FredericSegard/Original-Z80-Homebrew/2 - Clock/Docs and images/2 - Clock without components.jpg

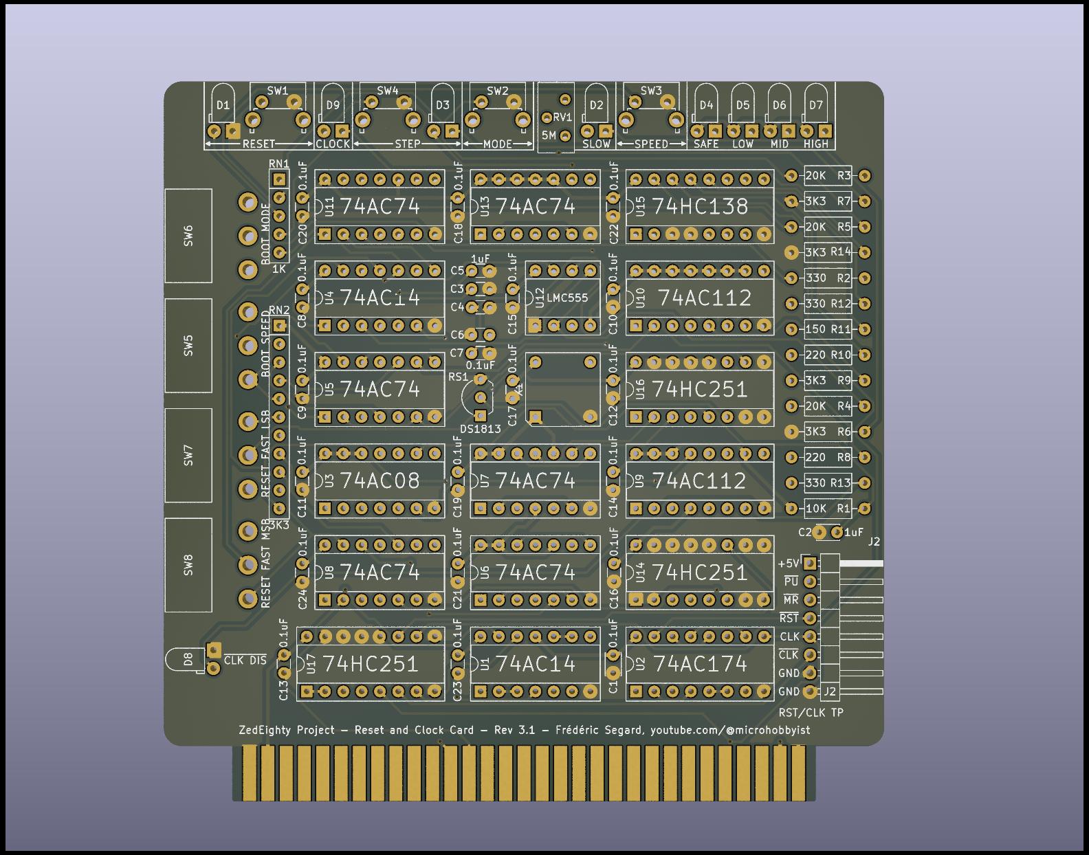
2 - Clock/Docs and images/2 - Clock without components.jpg
