FredericSegard/Original-Z80-Homebrew/README.md

# Original Z80 Homebrew
 This is my original homebrew design
