FredericSegard/Original-Z80-Homebrew/2 - Clock/Docs and images/2 - Clock back.jpg

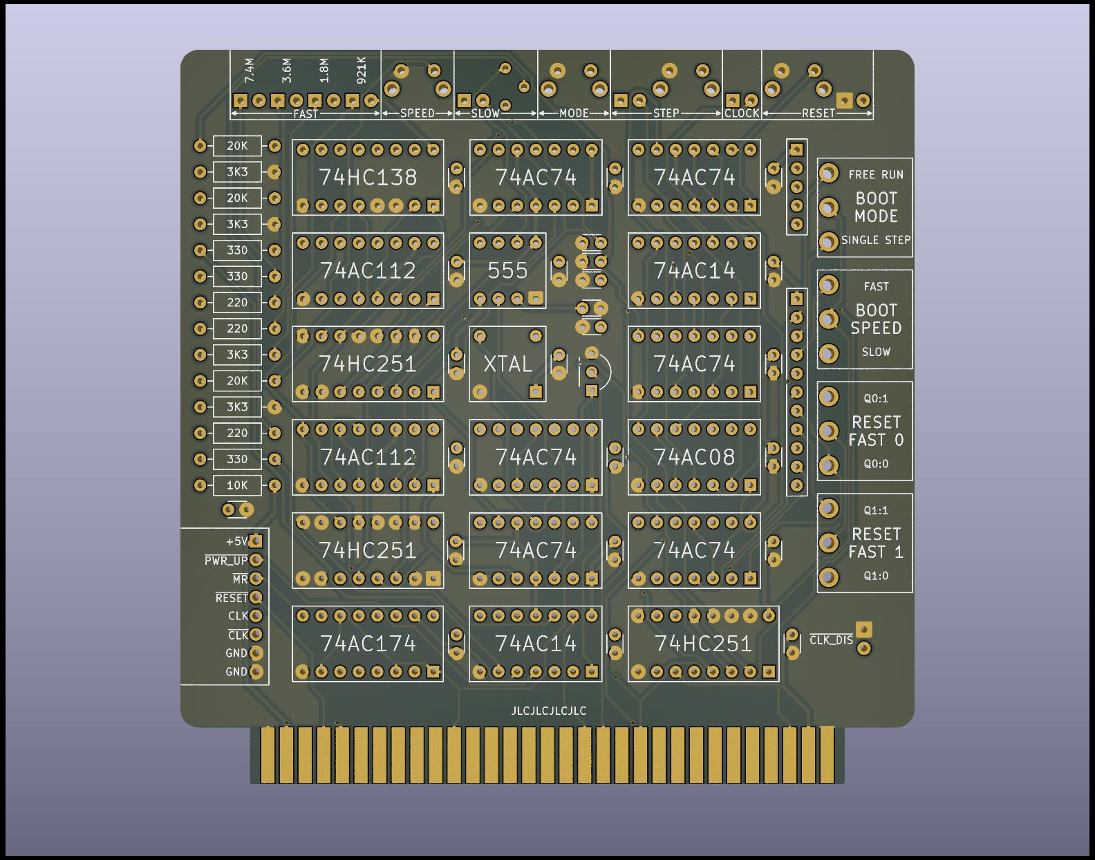
2 - Clock/Docs and images/2 - Clock back.jpg
