FredericSegard/Original-Z80-Homebrew/4 - Quad serial/Docs and images/4 - Quad serial (view 1).jpg

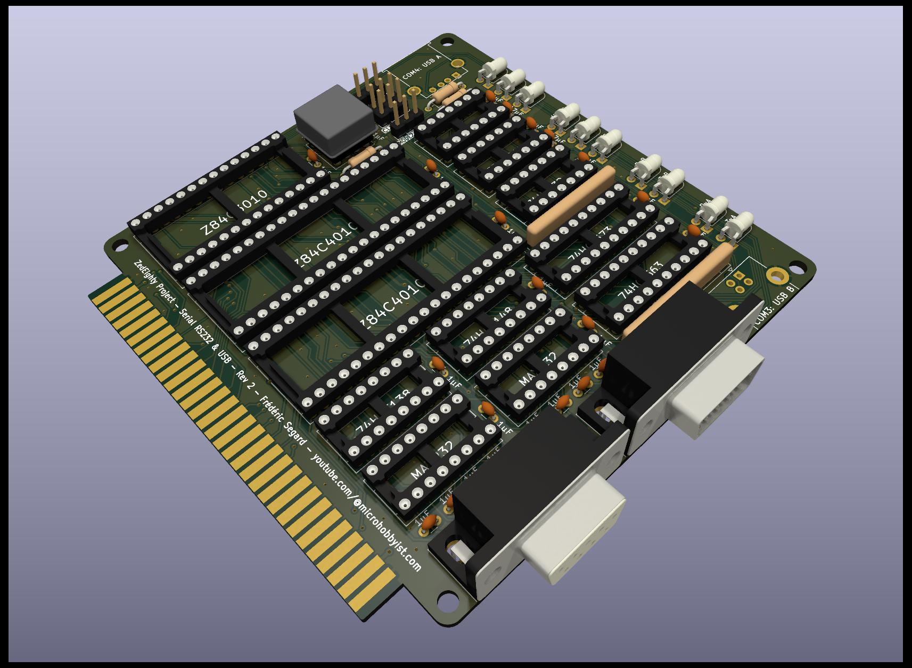
4 - Quad serial/Docs and images/4 - Quad serial (view 1).jpg
