FredericSegard/Original-Z80-Homebrew/1 - Backplkane/Docs and images/1 - Backplkane - front with components.jpg

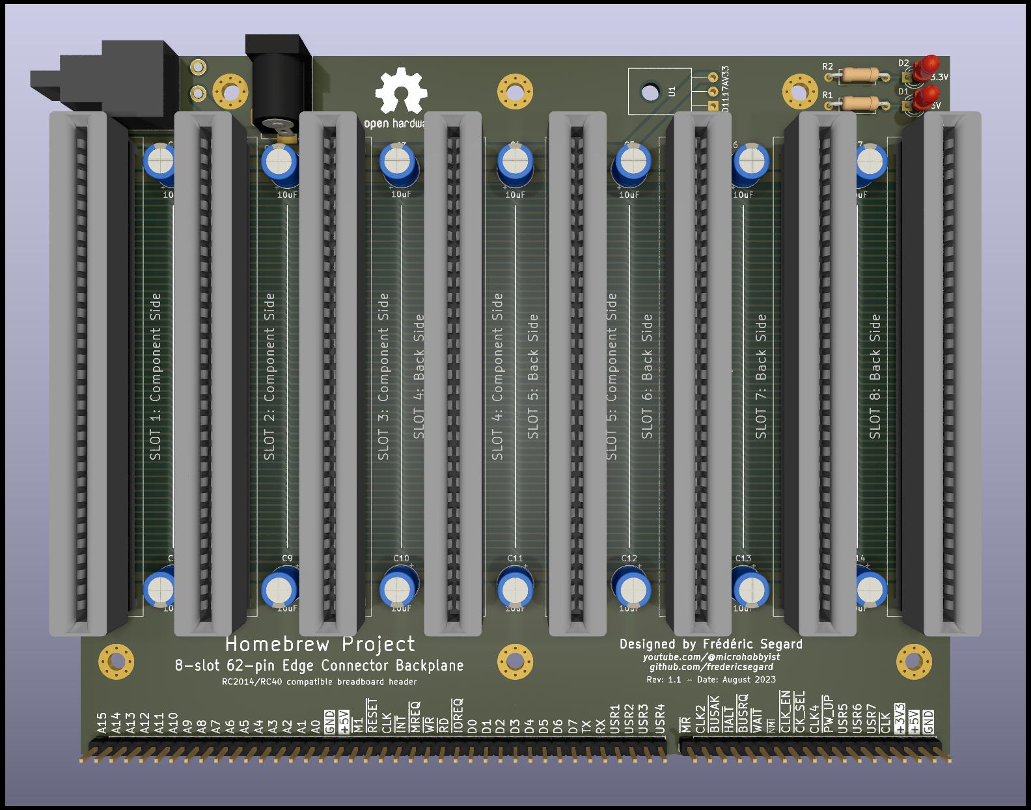
1 - Backplkane/Docs and images/1 - Backplkane - front with components.jpg
