FredericSegard/Original-Z80-Homebrew/1 - Backplkane/Docs and images/1 - Backplkane - front without components.jpg

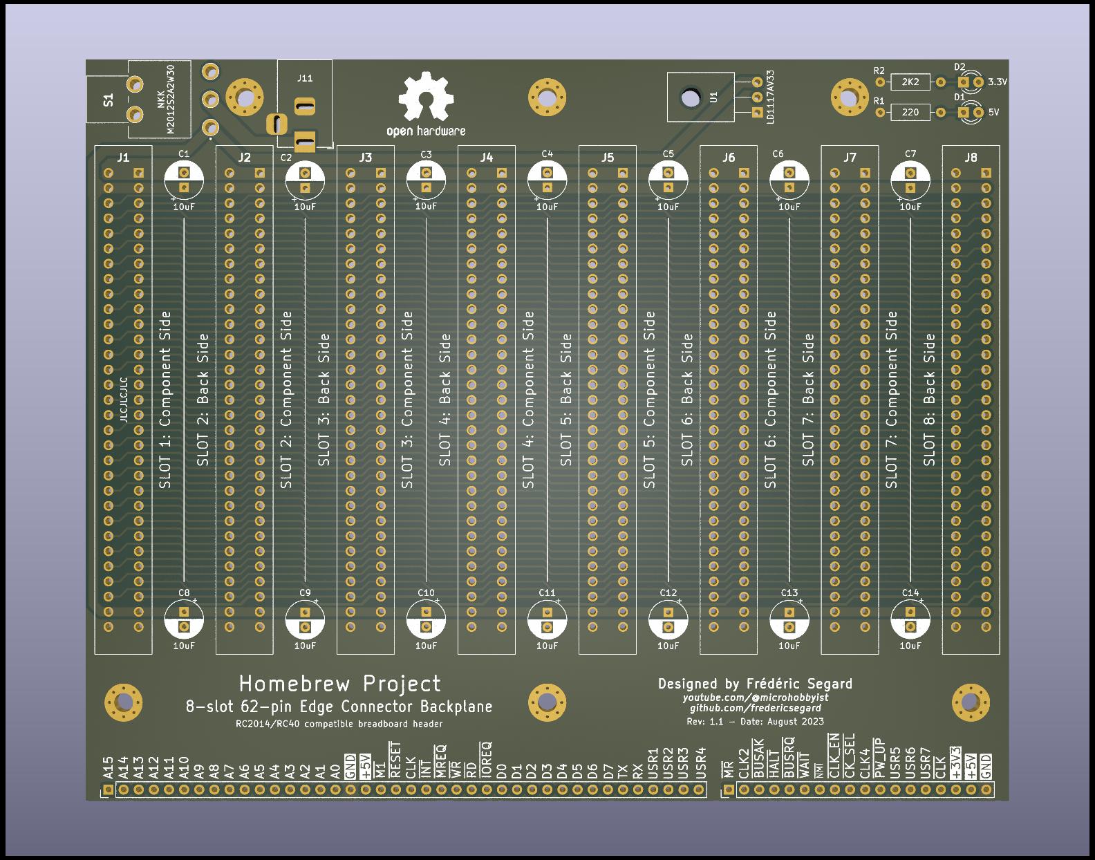
1 - Backplkane/Docs and images/1 - Backplkane - front without components.jpg
