FredericSegard/Original-Z80-Homebrew/3 - CPU and memory/Docs and images/3 - CPU and memory with components.jpg

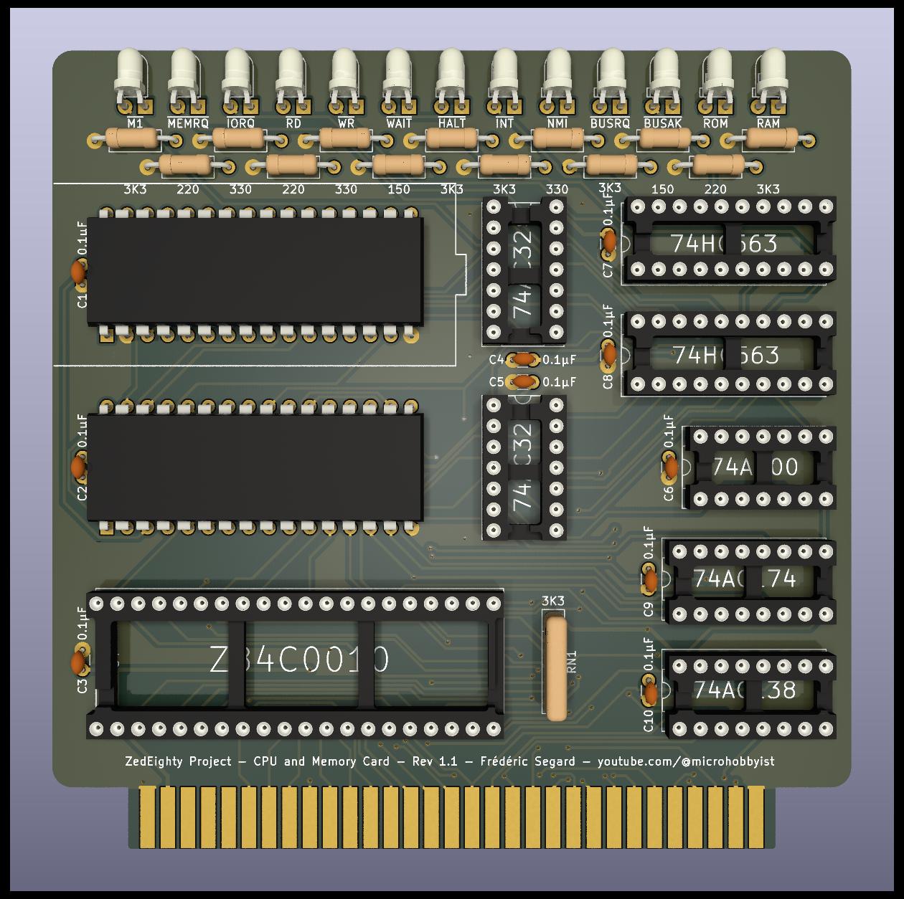
3 - CPU and memory/Docs and images/3 - CPU and memory with components.jpg
