FredericSegard/Original-Z80-Homebrew/4 - Quad serial/Docs and images/4 - Quad serial.jpg (front with components).jpg

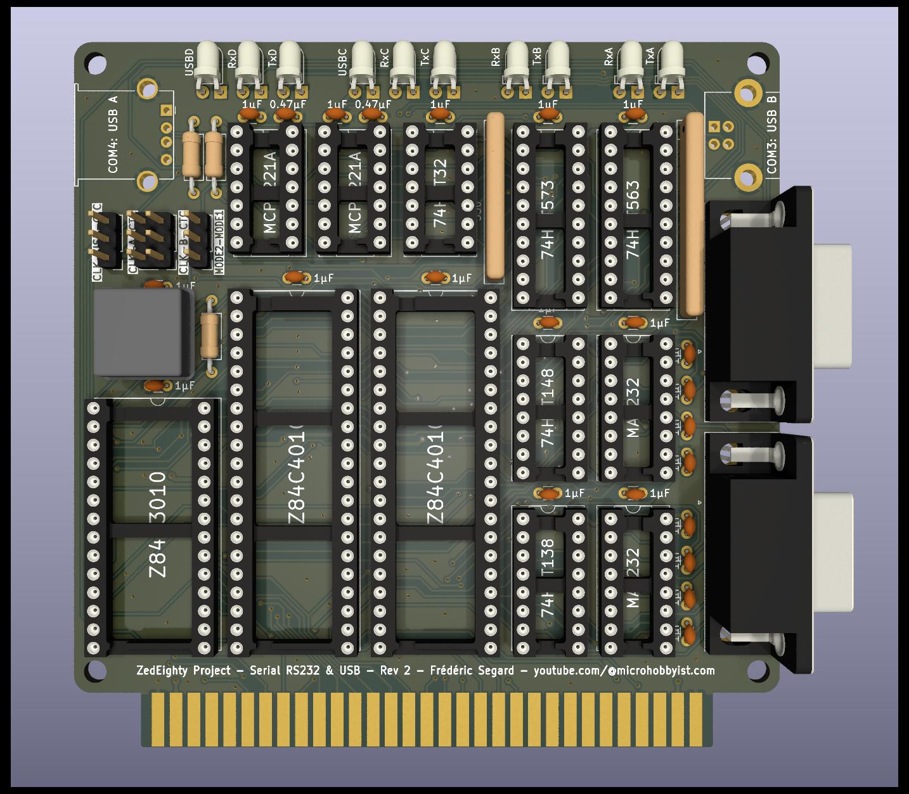
4 - Quad serial/Docs and images/4 - Quad serial.jpg (front with components).jpg
