FredericSegard/Original-Z80-Homebrew/4 - Quad serial/Docs and images/4 - Quad serial.pdf

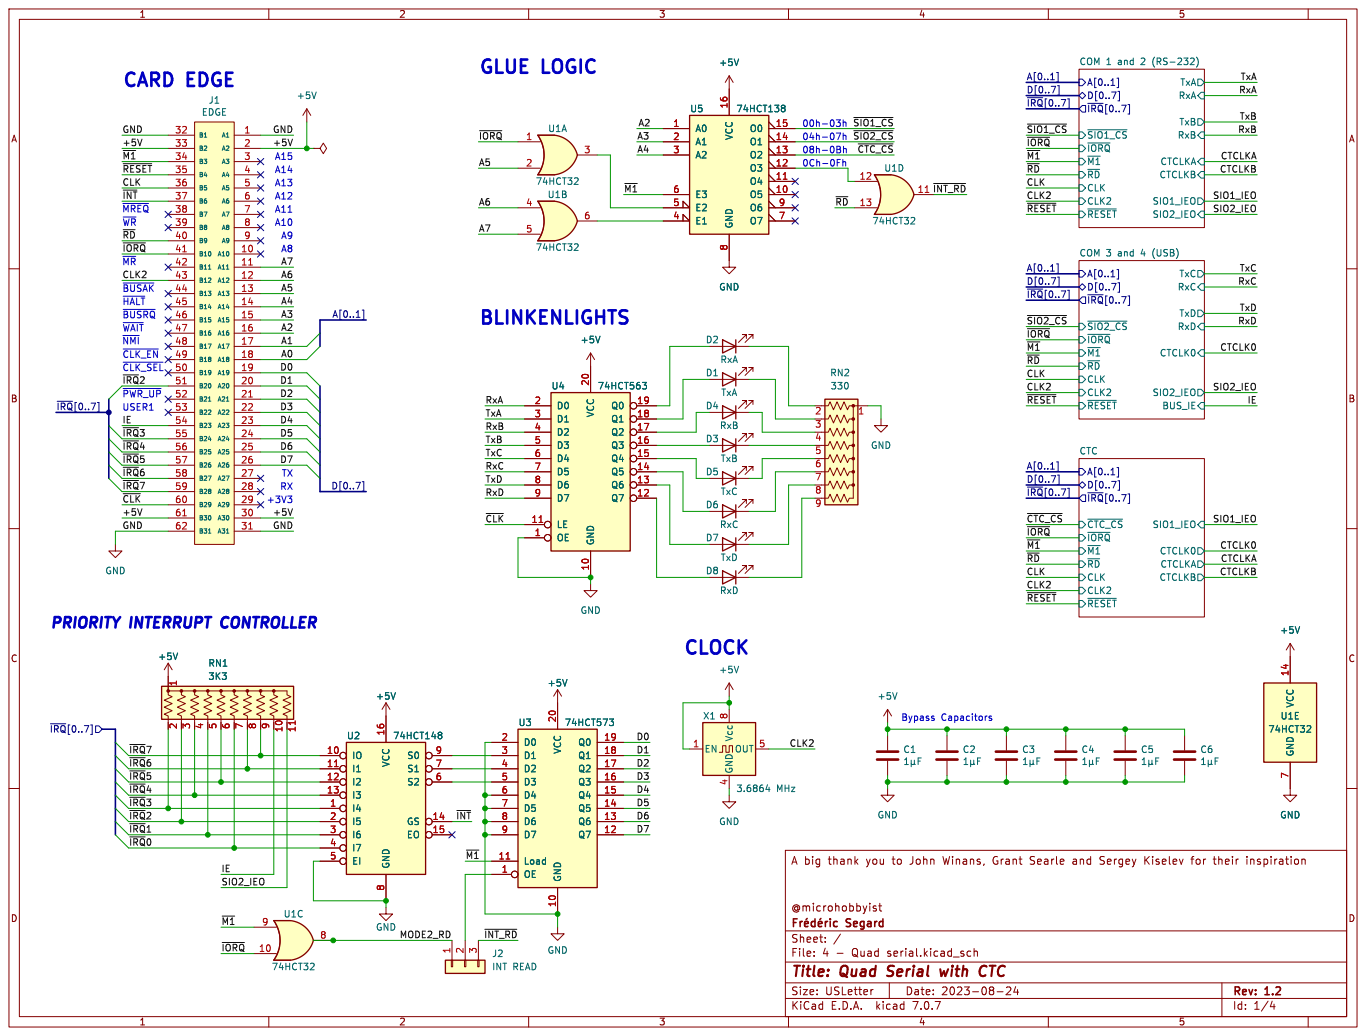
[picture p13: page 1]

CTCLKA CTCLKB COM 1 and 2 (RS-232) TxD

CTCLKA CTCLKB CTC GND

Id: 1/4 Title: Quad Serial with CTC

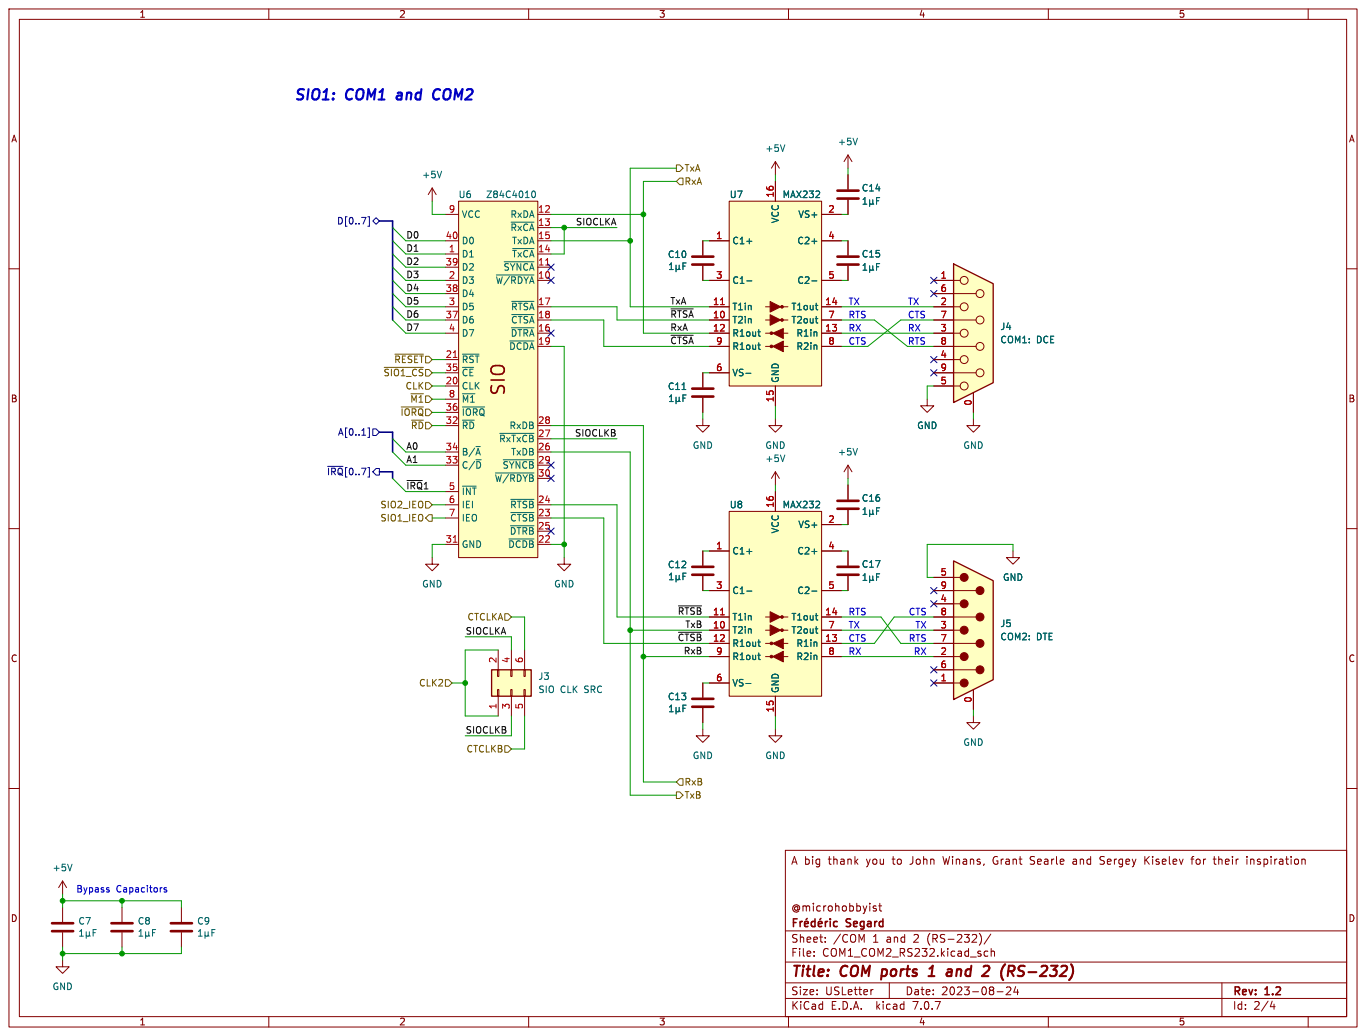
[picture p14: page 2]

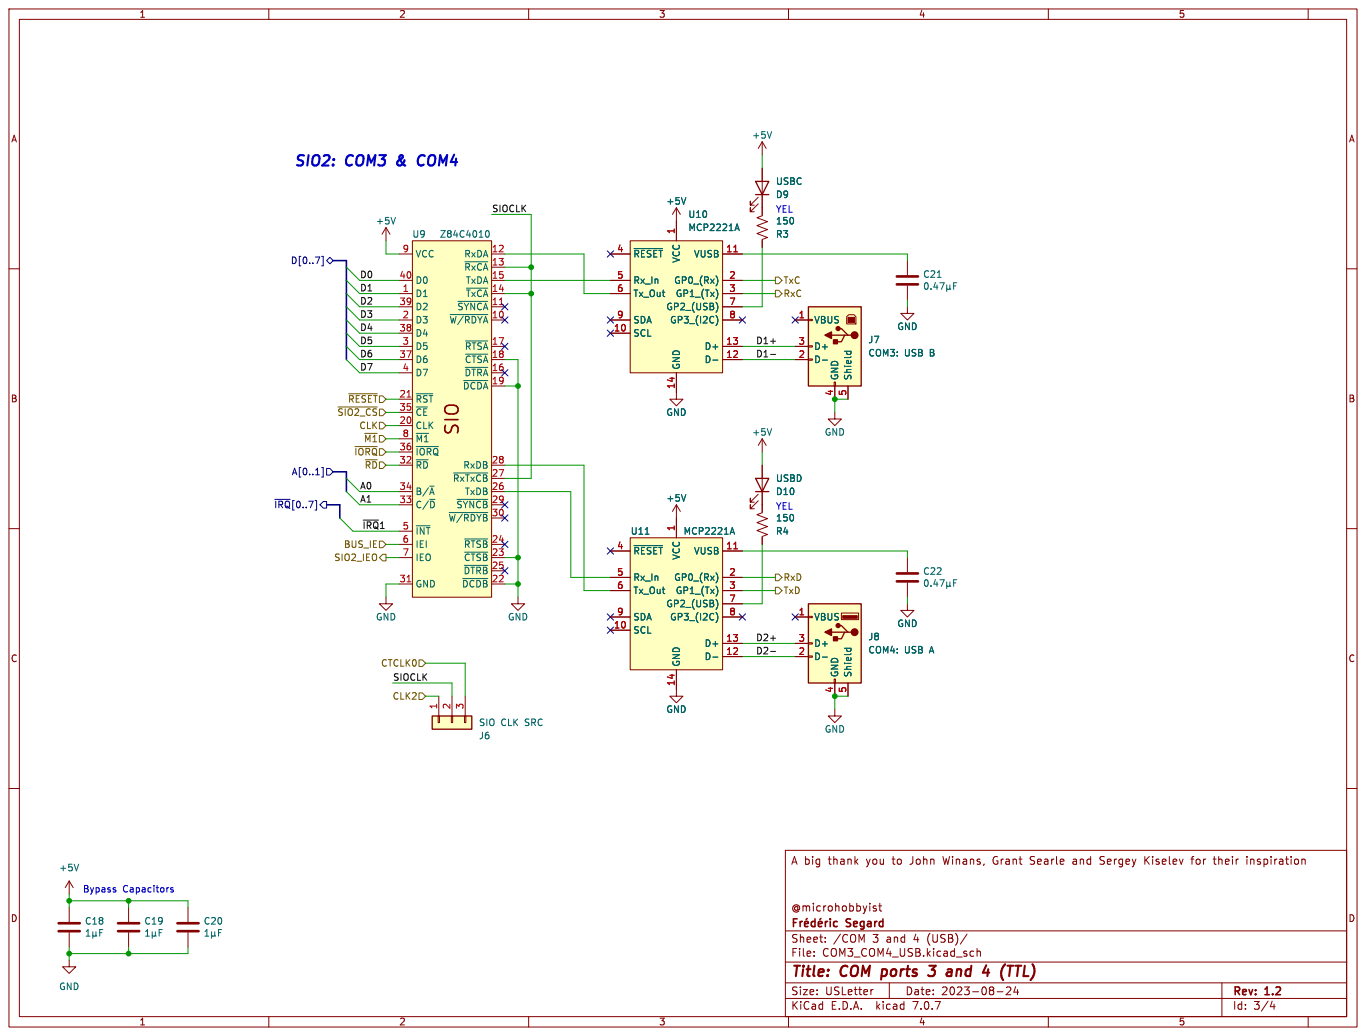
[picture p15: page 3]

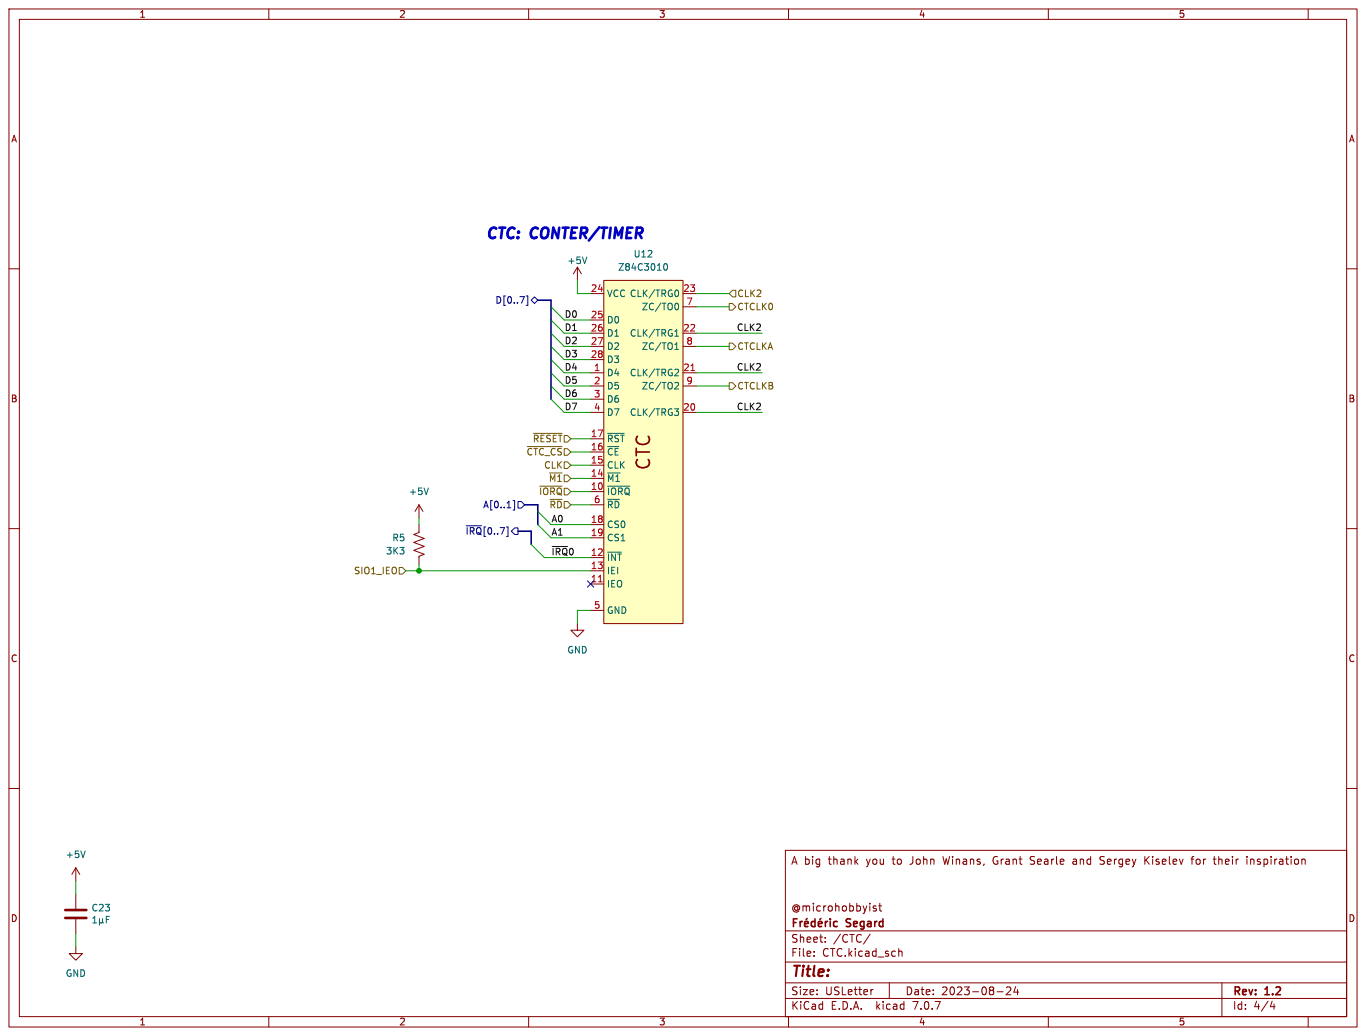
[picture p16: page 4]

Id: 4/4 Title: File: CTC.kicad_sch Sheet: /CTC/ þÿFrédéric Segard
