FredericSegard/Original-Z80-Homebrew/3 - CPU and memory/Docs and images/3 - CPU and memory.pdf

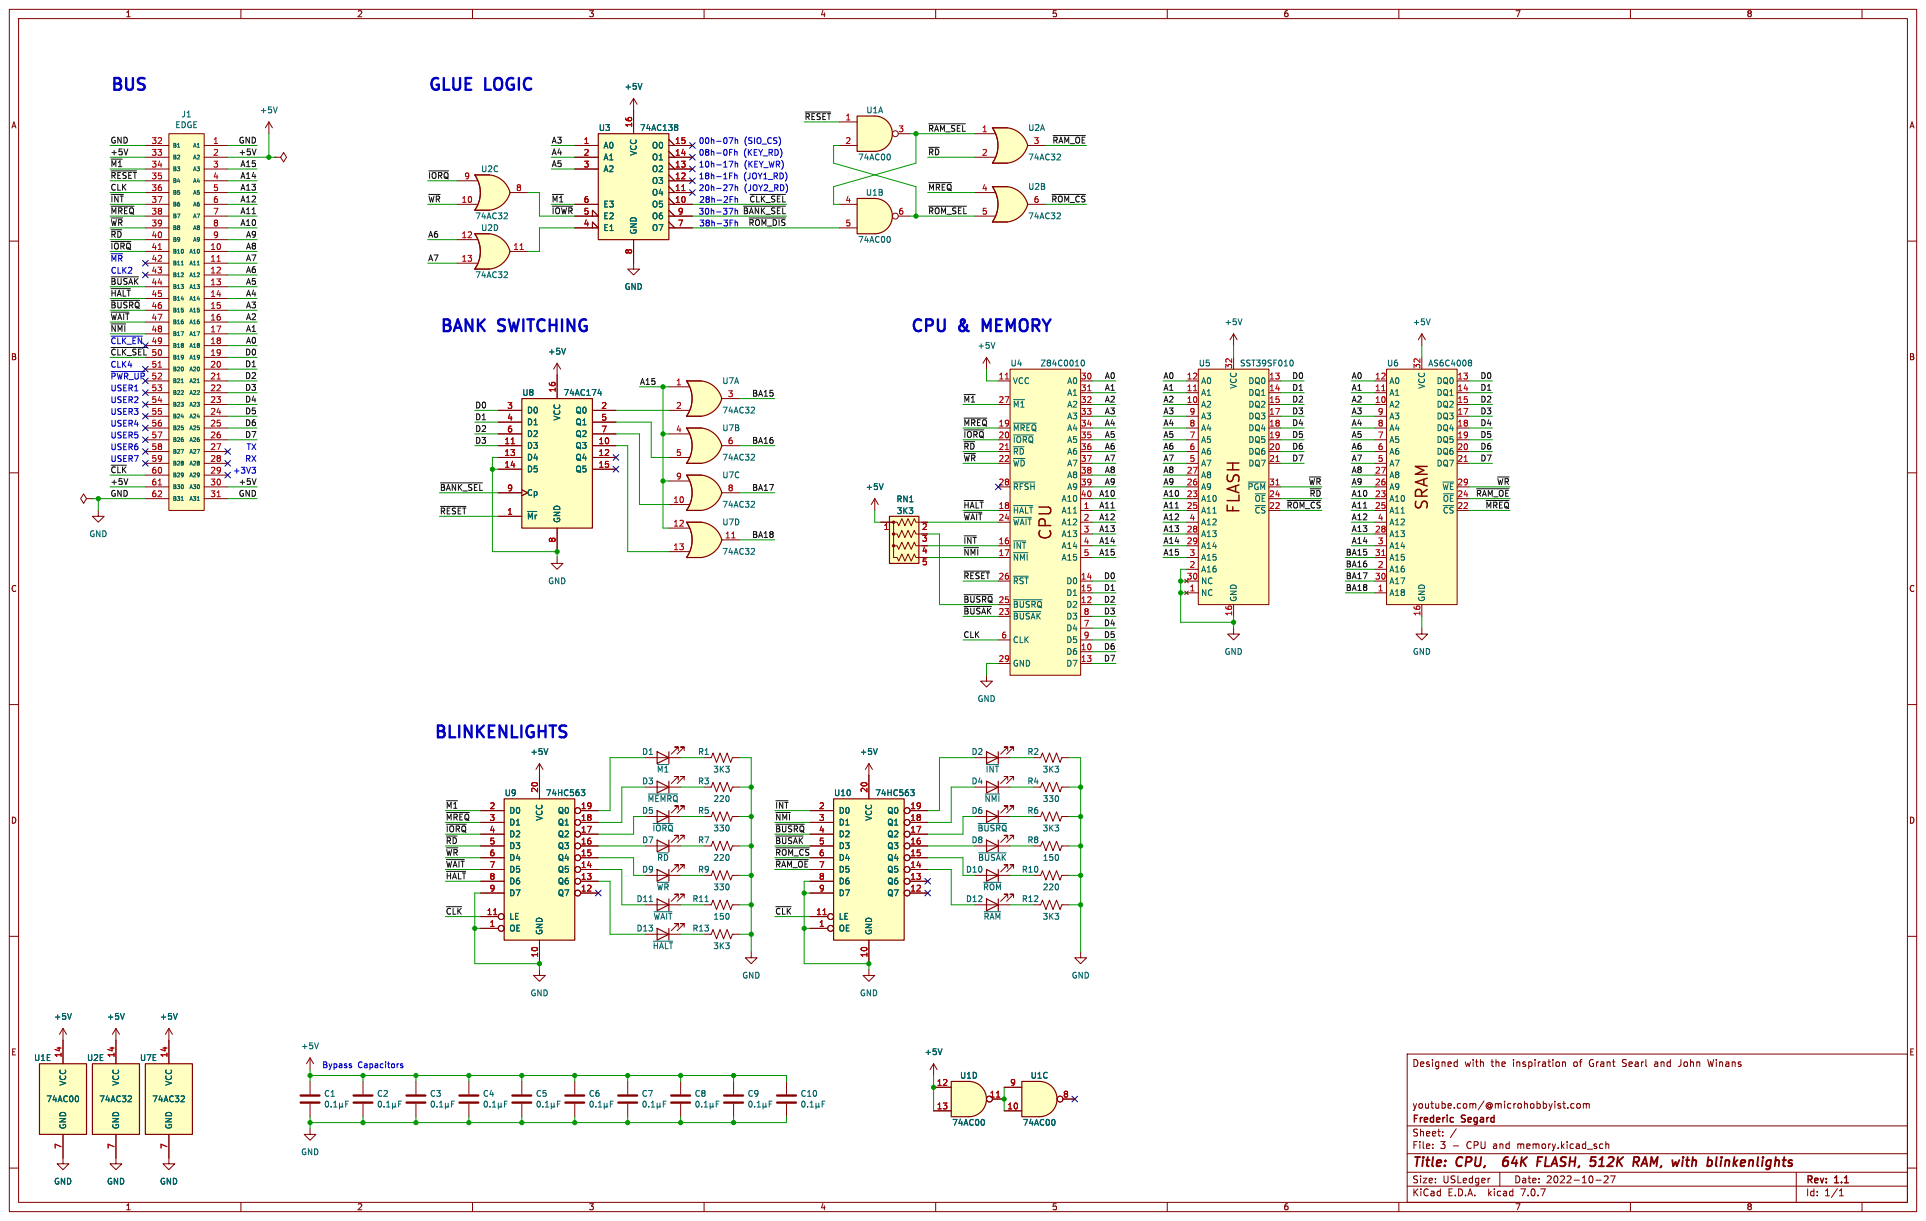
[picture p17: page 1]

youtube.com/@microhobbyist.com
File: 3 - CPU and memory.kicad_sch Sheet: / Frederic Segard
