FredericSegard/Original-Z80-Homebrew/2 - Clock/Docs and images/2 - Clock.pdf

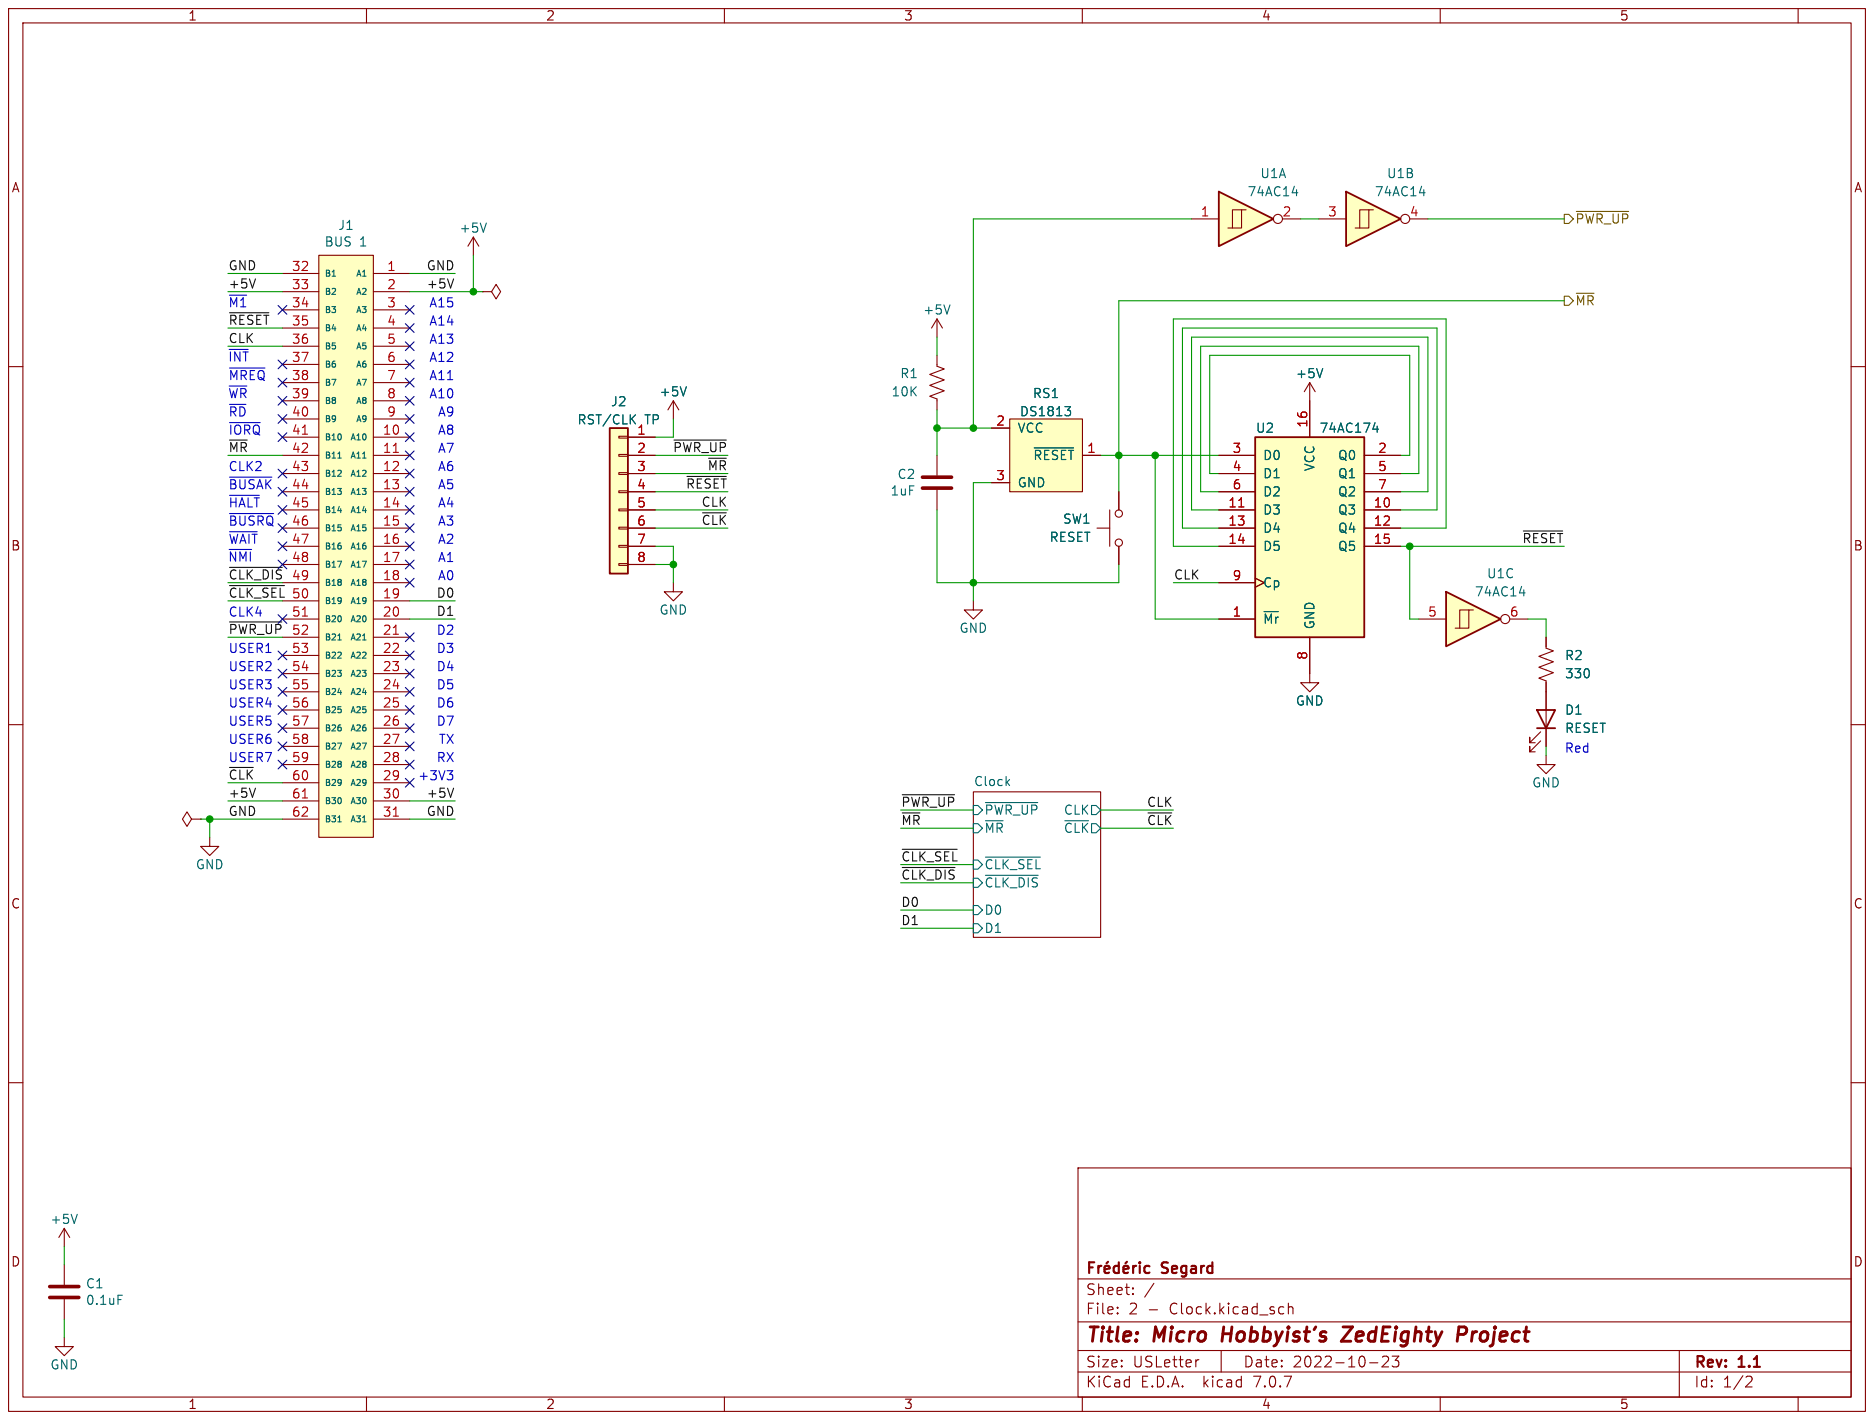
[picture p18: page 1]

Id: 1/2 Title: Micro Hobbyist's ZedEighty Project File: 2 - Clock.kicad_sch Sheet: / þÿFrédéric Segard

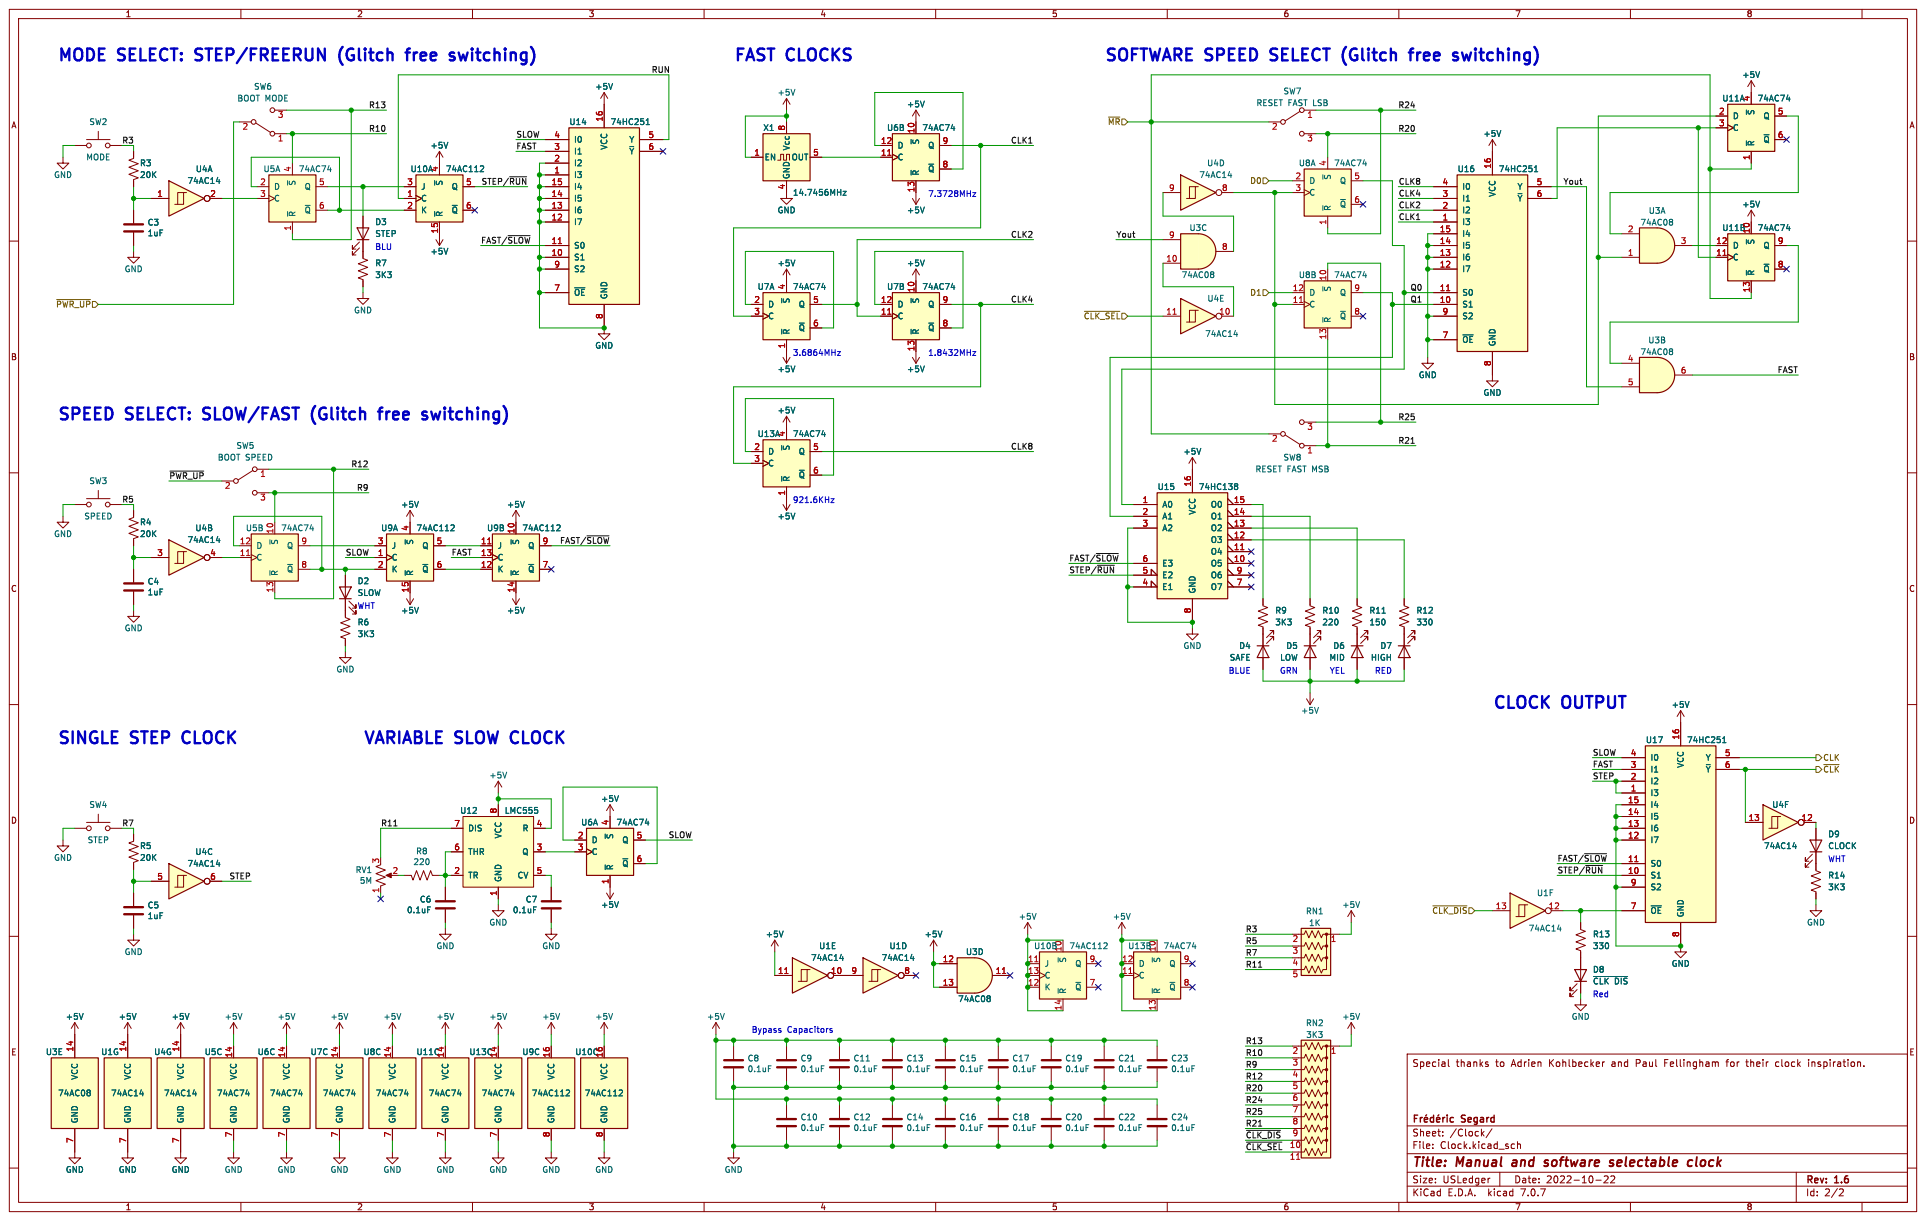
[picture p19: page 2]

File: Clock.kicad_sch Sheet: /Clock/ þÿFrédéric Segard
