FredericSegard/Original-Z80-Homebrew/1 - Backplkane/Docs and images/1 - Backplkane.pdf

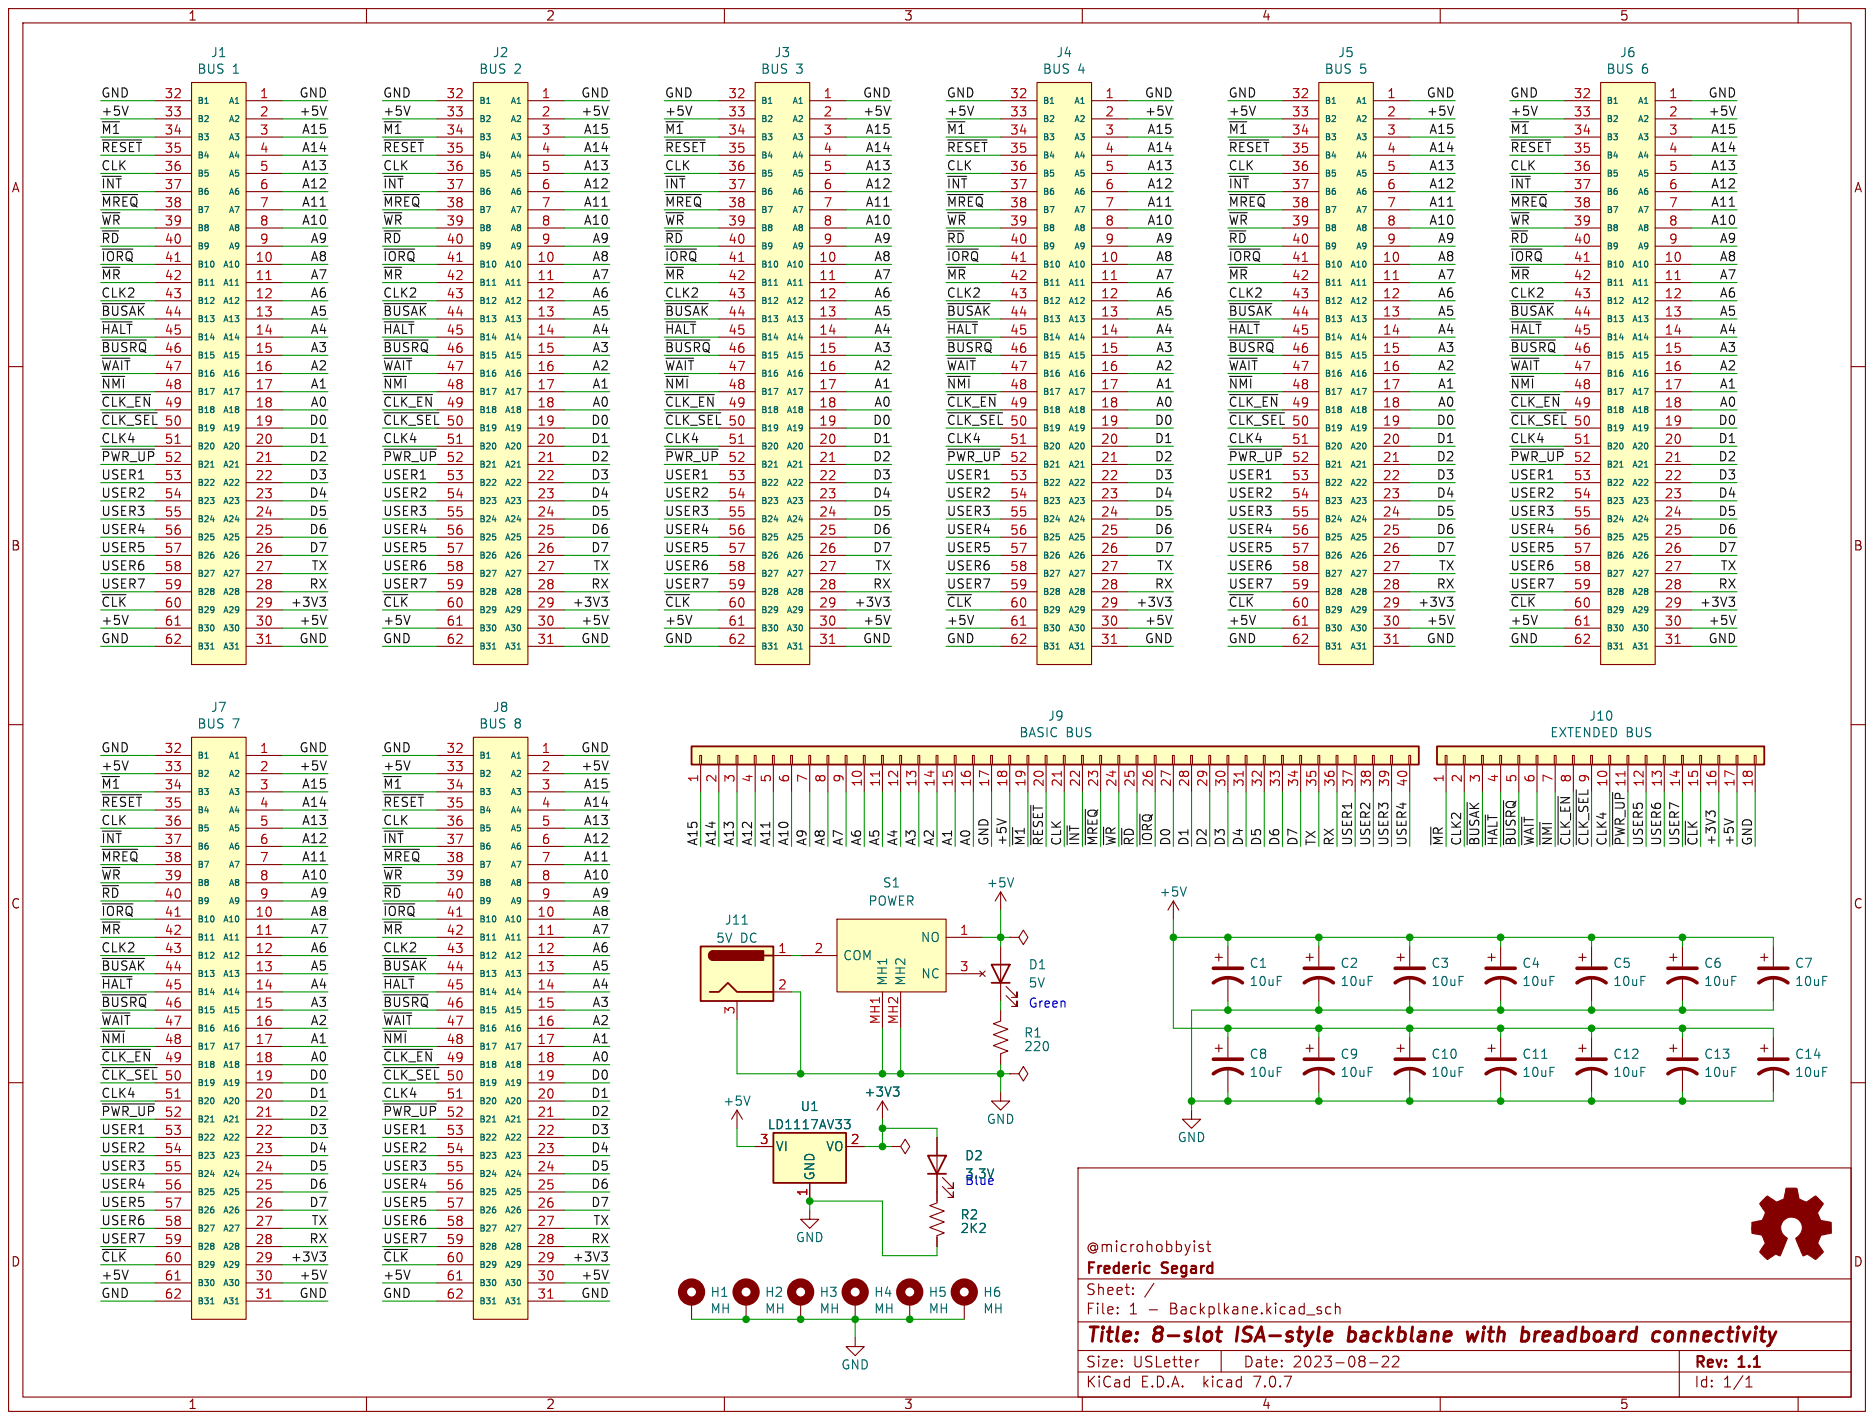
[picture p20: page 1]

9 J10 EXTENDED BUS NO 1 COM 2 NC 3 MH1 MH1 MH2 MH2 S1 POWER
