FredericSegard/Original-Z80-Homebrew/(list of files, drawings)

Other design files:
3 - CPU and memory/3 - CPU and memory.dsn
4 - Quad serial/3 - Quad Serial card v3.dsn
