FredericSegard/Original-Z80-Homebrew/4 - Quad serial/4 - Quad serial.kicad_pcb

## KiCad design 4 - Quad serial/4 - Quad serial.kicad_pcb (2023-09-11)

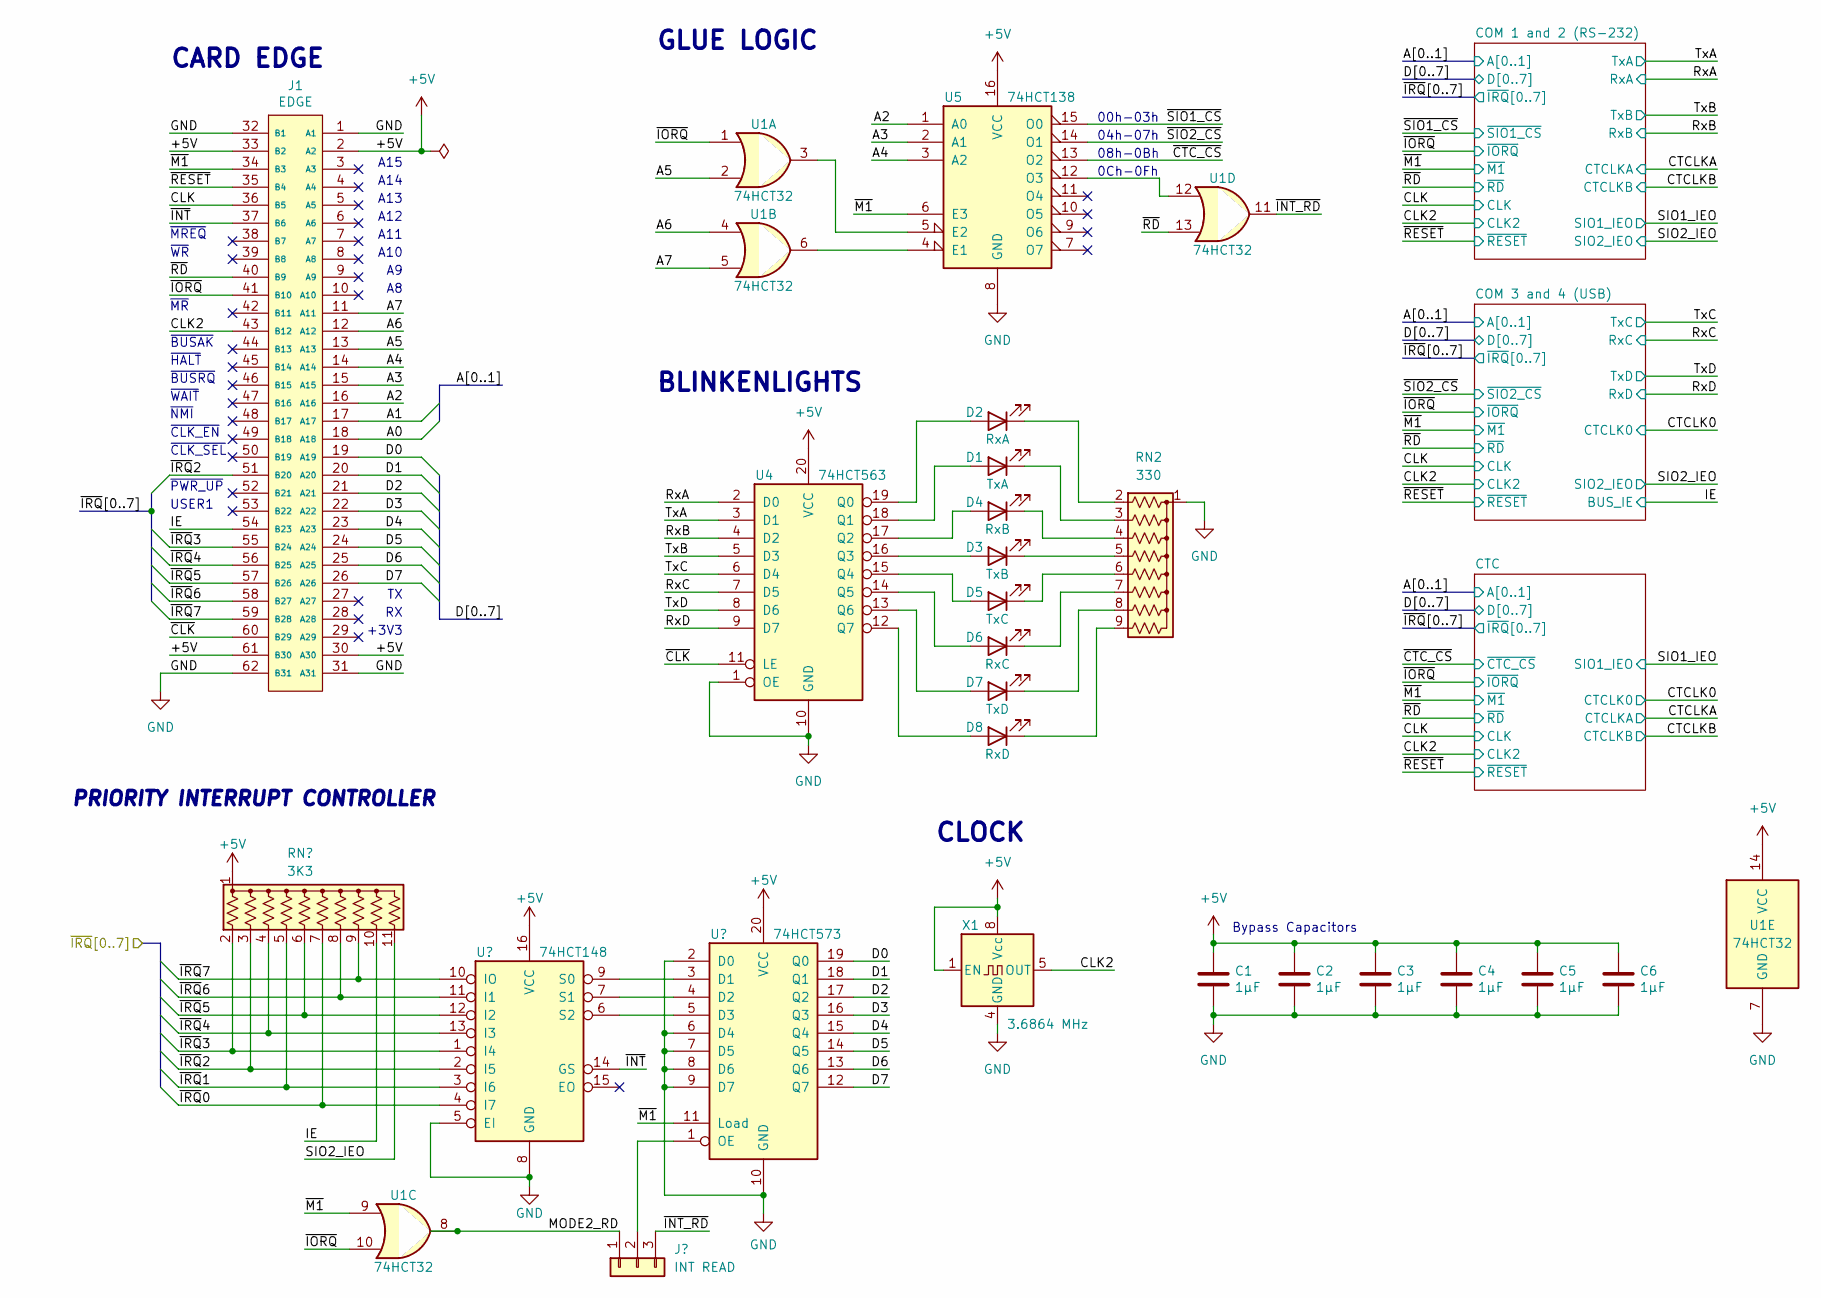
[picture p21: schematic 4 - Quad serial.kicad_sch, Quad Serial with CTC]

Parts:
C1, C2, C3, C4, C5, C6: 1µF; C_Disc_D3.0mm_W1.6mm_P2.50mm
D1: TxA; LED_D3.0mm_Horizontal_O1.27mm_Z2.0mm_Clear
D2: RxA; LED_D3.0mm_Horizontal_O1.27mm_Z2.0mm_Clear
D3: TxB; LED_D3.0mm_Horizontal_O1.27mm_Z2.0mm_Clear
D4: RxB; LED_D3.0mm_Horizontal_O1.27mm_Z2.0mm_Clear
D5: TxC; LED_D3.0mm_Horizontal_O1.27mm_Z2.0mm_Clear
D6: RxC; LED_D3.0mm_Horizontal_O1.27mm_Z2.0mm_Clear
D7: TxD; LED_D3.0mm_Horizontal_O1.27mm_Z2.0mm_Clear
D8: RxD; LED_D3.0mm_Horizontal_O1.27mm_Z2.0mm_Clear
J1: EDGE; BUS_XT_Proto; Mouser Part Number 571-6-5530843-5
J2: INT READ; PinHeader_1x03_P2.54mm_Vertical
RN1: 3K3; R_Array_SIP11
RN2: 330; R_Array_SIP9
U1: 74HCT32; DIP-14_W7.62mm_Socket
U2: 74HCT148; DIP-16_W7.62mm_Socket
U3: 74HCT573; DIP-20_W7.62mm_Socket
U4: 74HCT563; DIP-20_W7.62mm_Socket
U5: 74HCT138; DIP-16_W7.62mm_Socket
X1: 3.6864 MHz; DIP-8-4_W7.62mm_Oscillator_Socket

Connections:
+5V: C1.1, C2.1, C3.1, C4.1, C5.1, C6.1, J1.2 (A2), J1.30 (A30), J1.33 (B2), J1.61 (B30), RN1.1 (common), U1.14 (VCC), U2.16 (VCC), U3.20 (VCC), U4.20 (VCC), U5.16 (VCC), X1.1 (EN), X1.8 (Vcc); also elsewhere on the board
/A0: J1.18 (A18); also elsewhere on the board
/A1: J1.17 (A17); also elsewhere on the board
/A2: J1.16 (A16), U5.1 (A0)
/A3: J1.15 (A15), U5.2 (A1)
/A4: J1.14 (A14), U5.3 (A2)
/A5: J1.13 (A13), U1.2
/A6: J1.12 (A12), U1.4
/A7: J1.11 (A11), U1.5
/CLK: J1.36 (B5); also elsewhere on the board
/CLK2: J1.43 (B12), X1.5 (OUT); also elsewhere on the board
/D0: J1.19 (A19), U3.19 (Q0); also elsewhere on the board
/D1: J1.20 (A20), U3.18 (Q1); also elsewhere on the board
/D2: J1.21 (A21), U3.17 (Q2); also elsewhere on the board
/D3: J1.22 (A22), U3.16 (Q3); also elsewhere on the board
/D4: J1.23 (A23), U3.15 (Q4); also elsewhere on the board
/D5: J1.24 (A24), U3.14 (Q5); also elsewhere on the board
/D6: J1.25 (A25), U3.13 (Q6); also elsewhere on the board
/D7: J1.26 (A26), U3.12 (Q7); also elsewhere on the board
/IE: J1.54 (B23), RN1.10 (R9); also elsewhere on the board
/MODE2_RD: J2.1, U1.8
/RxA: U4.2 (D0); also elsewhere on the board
/RxB: U4.4 (D2); also elsewhere on the board
/RxC: U4.7 (D5); also elsewhere on the board
/RxD: U4.9 (D7); also elsewhere on the board
/SIO2_IEO: RN1.11 (R10); also elsewhere on the board
/TxA: U4.3 (D1); also elsewhere on the board
/TxB: U4.5 (D3); also elsewhere on the board
/TxC: U4.6 (D4); also elsewhere on the board
/TxD: U4.8 (D6); also elsewhere on the board
/~CLK: J1.60 (B29), U4.11 (LE)
/~CTC_CS: U5.13 (O2); also elsewhere on the board
/~INT_RD: J2.3, U1.11
/~INT: J1.37 (B6), U2.14 (GS)
/~IORQ: J1.41 (B10), U1.1, U1.10; also elsewhere on the board
/~IRQ0: RN1.7 (R6), U2.4 (I7); also elsewhere on the board
/~IRQ1: RN1.5 (R4), U2.3 (I6); also elsewhere on the board
/~IRQ2: J1.51 (B20), RN1.3 (R2), U2.2 (I5)
/~IRQ3: J1.55 (B24), RN1.2 (R1), U2.1 (I4)
/~IRQ4: J1.56 (B25), RN1.4 (R3), U2.13 (I3)
/~IRQ5: J1.57 (B26), RN1.6 (R5), U2.12 (I2)
/~IRQ6: J1.58 (B27), RN1.8 (R7), U2.11 (I1)
/~IRQ7: J1.59 (B28), RN1.9 (R8), U2.10 (IO)
/~M1: J1.34 (B3), U1.9, U3.11 (Load), U5.6 (E3); also elsewhere on the board
/~RD: J1.40 (B9), U1.13; also elsewhere on the board
/~RESET: J1.35 (B4); also elsewhere on the board
/~SIO1_CS: U5.15 (O0); also elsewhere on the board
/~SIO2_CS: U5.14 (O1); also elsewhere on the board
GND: C1.2, C2.2, C3.2, C4.2, C5.2, C6.2, J1.1 (A1), J1.31 (A31), J1.32 (B1), J1.62 (B31), RN2.1 (common), U1.7 (GND), U2.5 (EI), U2.8 (GND), U3.2 (D0), U3.6 (D4), U3.7 (D5), U3.8 (D6), U3.9 (D7), U3.10 (GND), U4.1 (OE), U4.10 (GND), U5.8 (GND), X1.4 (GND); also elsewhere on the board
unnamed: D1.2 (A), U4.18 (Q1)
unnamed: D1.1 (K), RN2.3 (R2)
unnamed: D2.2 (A), U4.19 (Q0)
unnamed: D2.1 (K), RN2.2 (R1)
unnamed: D3.2 (A), U4.16 (Q3)
unnamed: D3.1 (K), RN2.5 (R4)
unnamed: D4.2 (A), U4.17 (Q2)
unnamed: D4.1 (K), RN2.4 (R3)
unnamed: D5.2 (A), U4.15 (Q4)
unnamed: D5.1 (K), RN2.6 (R5)
unnamed: D6.2 (A), U4.14 (Q5)
unnamed: D6.1 (K), RN2.7 (R6)
unnamed: D7.2 (A), U4.13 (Q6)
unnamed: D7.1 (K), RN2.8 (R7)
unnamed: D8.2 (A), U4.12 (Q7)
unnamed: D8.1 (K), RN2.9 (R8)
unnamed: J2.2, U3.1 (OE)
unnamed: U2.9 (S0), U3.3 (D1)
unnamed: U2.7 (S1), U3.4 (D2)
unnamed: U2.6 (S2), U3.5 (D3)
unnamed: U1.6, U5.4 (E1)
unnamed: U1.3, U5.5 (E2)
unnamed: U1.12, U5.12 (O3)

Notes on the sheet:
PRIORITY INTERRUPT CONTROLLER
04h-07h
0Ch-0Fh
GLUE LOGIC
~{BUSAK}
+3V3
00h-03h
~{WR}
~{MR}
~{MREQ}
CARD EDGE
~{HALT}
BLINKENLIGHTS
CLOCK
~{CLK_EN}
USER1
~{BUSRQ}
~{WAIT}
~{PWR_UP}
~{CLK_SEL}
A12
A13
A14
A10
Bypass Capacitors
A15
~{NMI}
08h-0Bh
A11

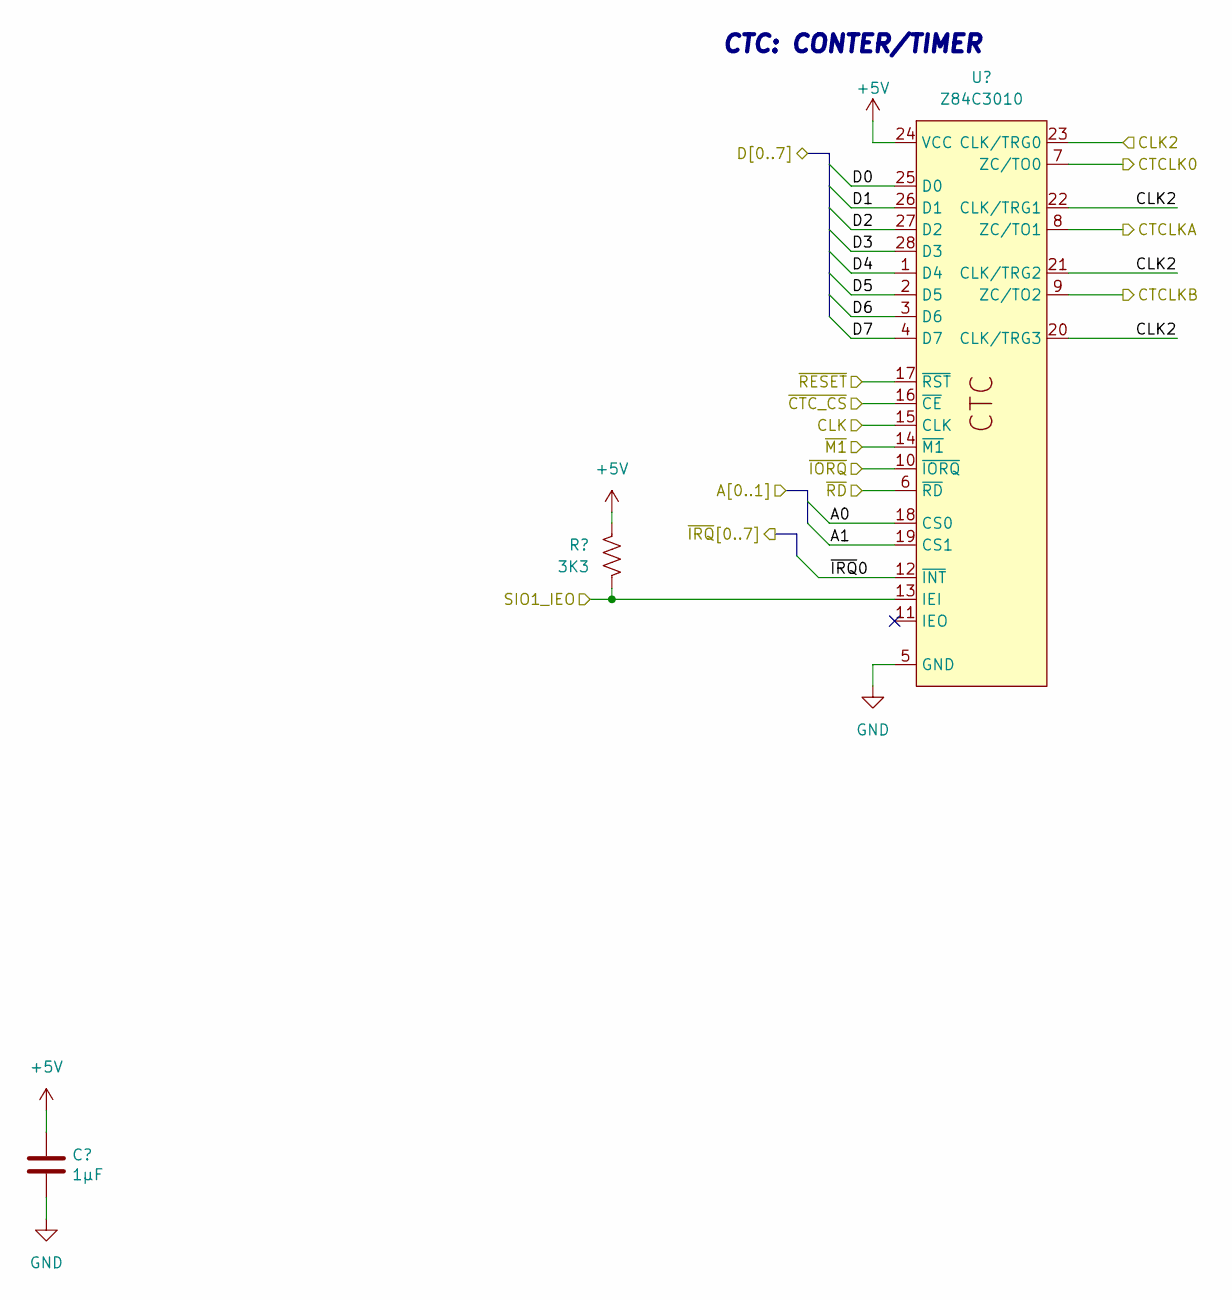
[picture p22: schematic CTC.kicad_sch]

Parts:
C23: 1µF; C_Disc_D3.0mm_W1.6mm_P2.50mm
R5: 3K3; R_Axial_DIN0207_L6.3mm_D2.5mm_P10.16mm_Horizontal
U12: Z84C3010; DIP-28_W15.24mm_Socket

Connections:
+5V: C23.1, R5.1, U12.24 (VCC); also elsewhere on the board
/A0: U12.18 (CS0); also elsewhere on the board
/A1: U12.19 (CS1); also elsewhere on the board
/CLK: U12.15 (CLK); also elsewhere on the board
/CLK2: U12.20 (CLK/TRG3), U12.21 (CLK/TRG2), U12.22 (CLK/TRG1), U12.23 (CLK/TRG0); also elsewhere on the board
/CTCLK0: U12.7 (ZC/TO0); also elsewhere on the board
/CTCLKA: U12.8 (ZC/TO1); also elsewhere on the board
/CTCLKB: U12.9 (ZC/TO2); also elsewhere on the board
/D0: U12.25 (D0); also elsewhere on the board
/D1: U12.26 (D1); also elsewhere on the board
/D2: U12.27 (D2); also elsewhere on the board
/D3: U12.28 (D3); also elsewhere on the board
/D4: U12.1 (D4); also elsewhere on the board
/D5: U12.2 (D5); also elsewhere on the board
/D6: U12.3 (D6); also elsewhere on the board
/D7: U12.4 (D7); also elsewhere on the board
/SIO1_IEO: R5.2, U12.13 (IEI); also elsewhere on the board
/~CTC_CS: U12.16 (~CE); also elsewhere on the board
/~IORQ: U12.10 (~IORQ); also elsewhere on the board
/~IRQ0: U12.12 (~INT); also elsewhere on the board
/~M1: U12.14 (~M1); also elsewhere on the board
/~RD: U12.6 (~RD); also elsewhere on the board
/~RESET: U12.17 (~RST); also elsewhere on the board
GND: C23.2, U12.5 (GND); also elsewhere on the board

Notes on the sheet:
CTC: CONTER/TIMER

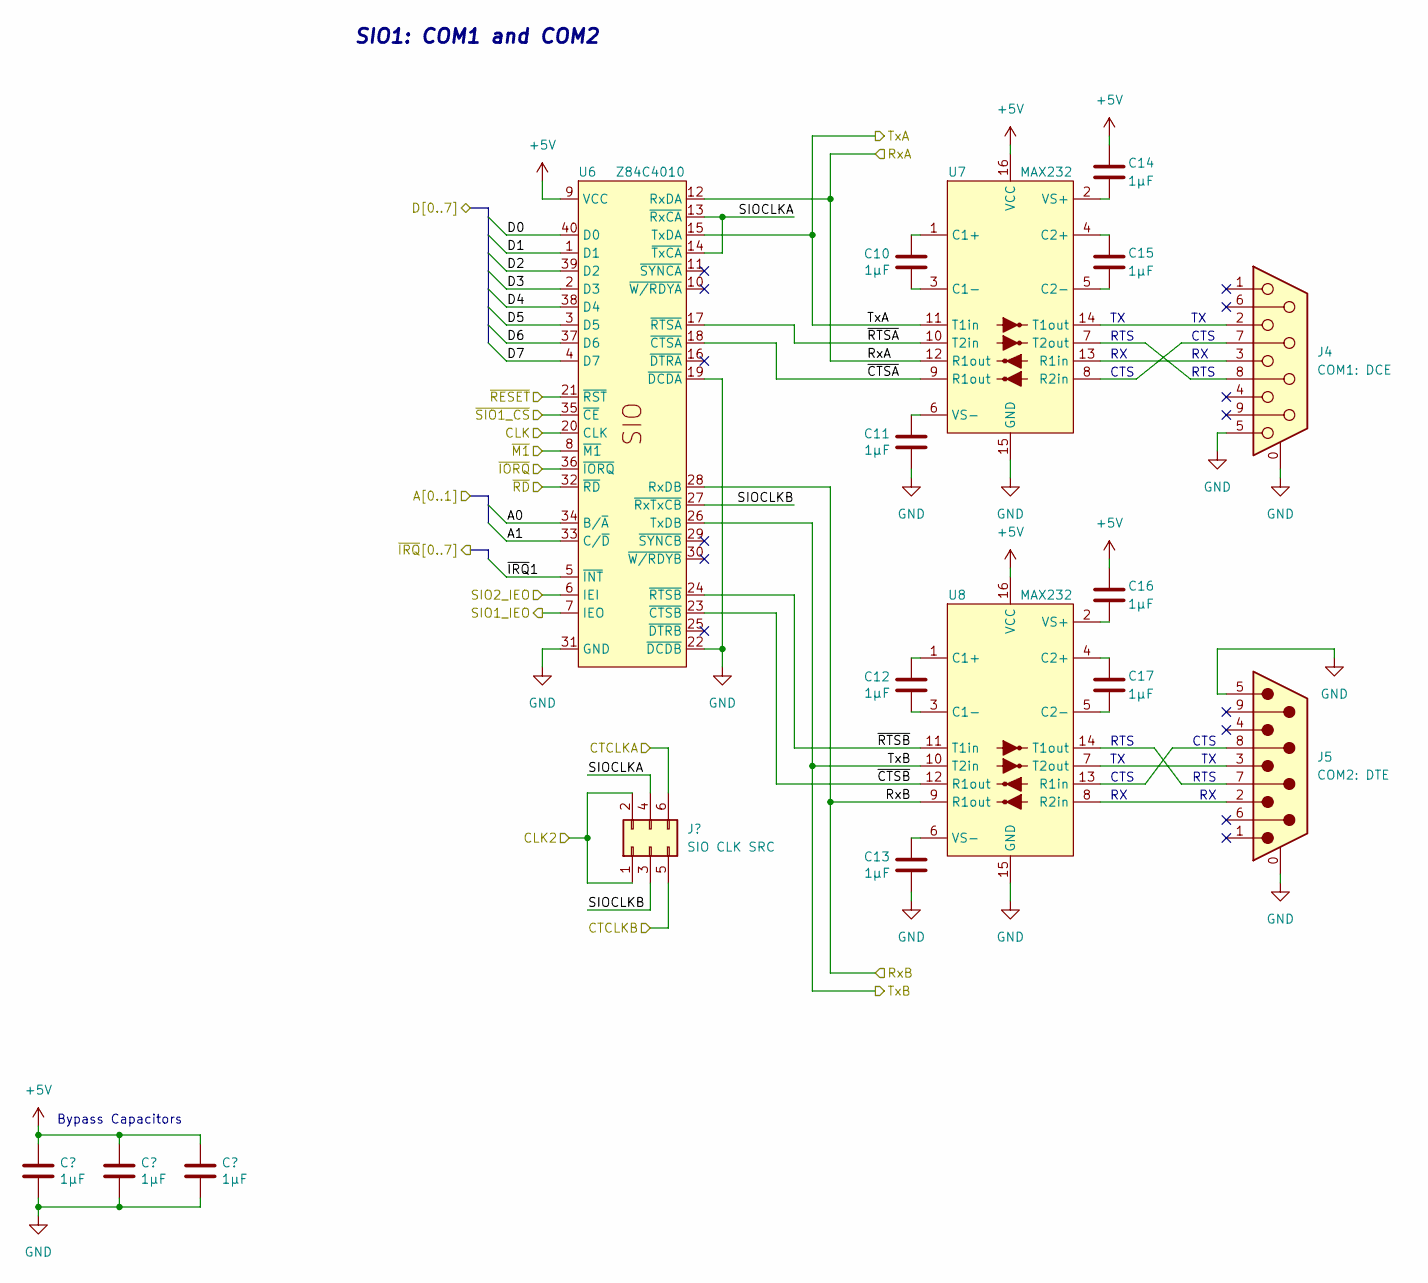
[picture p23: schematic COM1_COM2_RS232.kicad_sch, COM ports 1 and 2 (RS-232)]

Parts:
C7, C8, C9, C10, C11, C12, C13, C14, C15, C16, C17: 1µF; C_Disc_D3.0mm_W1.6mm_P2.50mm
J3: SIO CLK SRC; PinHeader_2x03_P2.54mm_Vertical
J4: COM1: DCE; DSUB-9_Female_Horizontal_P2.77x2.84mm_EdgePinOffset4.94mm_H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
J5: COM2: DTE; DSUB-9_Male_Horizontal_P2.77x2.84mm_EdgePinOffset4.94mm_Hou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
U6: Z84C4010; DIP-40_W15.24mm_Socket
U7, U8: MAX232; DIP-16_W7.62mm_Socket

Connections:
+5V: C7.1, C8.1, C9.1, C14.1, C16.1, U6.9 (VCC), U7.16 (VCC), U8.16 (VCC); also elsewhere on the board
/A0: U6.34 (B/~A); also elsewhere on the board
/A1: U6.33 (C/~D); also elsewhere on the board
/CLK: U6.20 (CLK); also elsewhere on the board
/CLK2: J3.1, J3.2; also elsewhere on the board
/COM 1 and 2 (RS-232)/SIOCLKA: J3.4, U6.13 (~RxCA), U6.14 (~TxCA)
/COM 1 and 2 (RS-232)/SIOCLKB: J3.3, U6.27 (~RxTxCB)
/COM 1 and 2 (RS-232)/~CTSA: U6.18 (~CTSA), U7.9 (R1out)
/COM 1 and 2 (RS-232)/~CTSB: U6.23 (~CTSB), U8.12 (R1out)
/COM 1 and 2 (RS-232)/~RTSA: U6.17 (~RTSA), U7.10 (T2in)
/COM 1 and 2 (RS-232)/~RTSB: U6.24 (~RTSB), U8.11 (T1in)
/CTCLKA: J3.6; also elsewhere on the board
/CTCLKB: J3.5; also elsewhere on the board
/D0: U6.40 (D0); also elsewhere on the board
/D1: U6.1 (D1); also elsewhere on the board
/D2: U6.39 (D2); also elsewhere on the board
/D3: U6.2 (D3); also elsewhere on the board
/D4: U6.38 (D4); also elsewhere on the board
/D5: U6.3 (D5); also elsewhere on the board
/D6: U6.37 (D6); also elsewhere on the board
/D7: U6.4 (D7); also elsewhere on the board
/RxA: U6.12 (RxDA), U7.12 (R1out); also elsewhere on the board
/RxB: U6.28 (RxDB), U8.9 (R1out); also elsewhere on the board
/SIO1_IEO: U6.7 (IEO); also elsewhere on the board
/SIO2_IEO: U6.6 (IEI); also elsewhere on the board
/TxA: U6.15 (TxDA), U7.11 (T1in); also elsewhere on the board
/TxB: U6.26 (TxDB), U8.10 (T2in); also elsewhere on the board
/~IORQ: U6.36 (~IORQ); also elsewhere on the board
/~IRQ1: U6.5 (~INT); also elsewhere on the board
/~M1: U6.8 (~M1); also elsewhere on the board
/~RD: U6.32 (~RD); also elsewhere on the board
/~RESET: U6.21 (~RST); also elsewhere on the board
/~SIO1_CS: U6.35 (~CE); also elsewhere on the board
GND: C7.2, C8.2, C9.2, C11.2, C13.2, J4.0 (PAD), J4.5, J5.0 (PAD), J5.5, U6.19 (~DCDA), U6.22 (~DCDB), U6.31 (GND), U7.15 (GND), U8.15 (GND); also elsewhere on the board
unnamed: C10.1, U7.1 (C1+)
unnamed: C10.2, U7.3 (C1-)
unnamed: C15.1, U7.4 (C2+)
unnamed: C15.2, U7.5 (C2-)
unnamed: J4.3, U7.13 (R1in)
unnamed: J4.7, U7.8 (R2in)
unnamed: J4.2, U7.14 (T1out)
unnamed: J4.8, U7.7 (T2out)
unnamed: C14.2, U7.2 (VS+)
unnamed: C11.1, U7.6 (VS-)
unnamed: C12.1, U8.1 (C1+)
unnamed: C12.2, U8.3 (C1-)
unnamed: C17.1, U8.4 (C2+)
unnamed: C17.2, U8.5 (C2-)
unnamed: J5.8, U8.13 (R1in)
unnamed: J5.2, U8.8 (R2in)
unnamed: J5.7, U8.14 (T1out)
unnamed: J5.3, U8.7 (T2out)
unnamed: C16.2, U8.2 (VS+)
unnamed: C13.1, U8.6 (VS-)

Notes on the sheet:
RTS
SIO1: COM1 and COM2
CTS
Bypass Capacitors

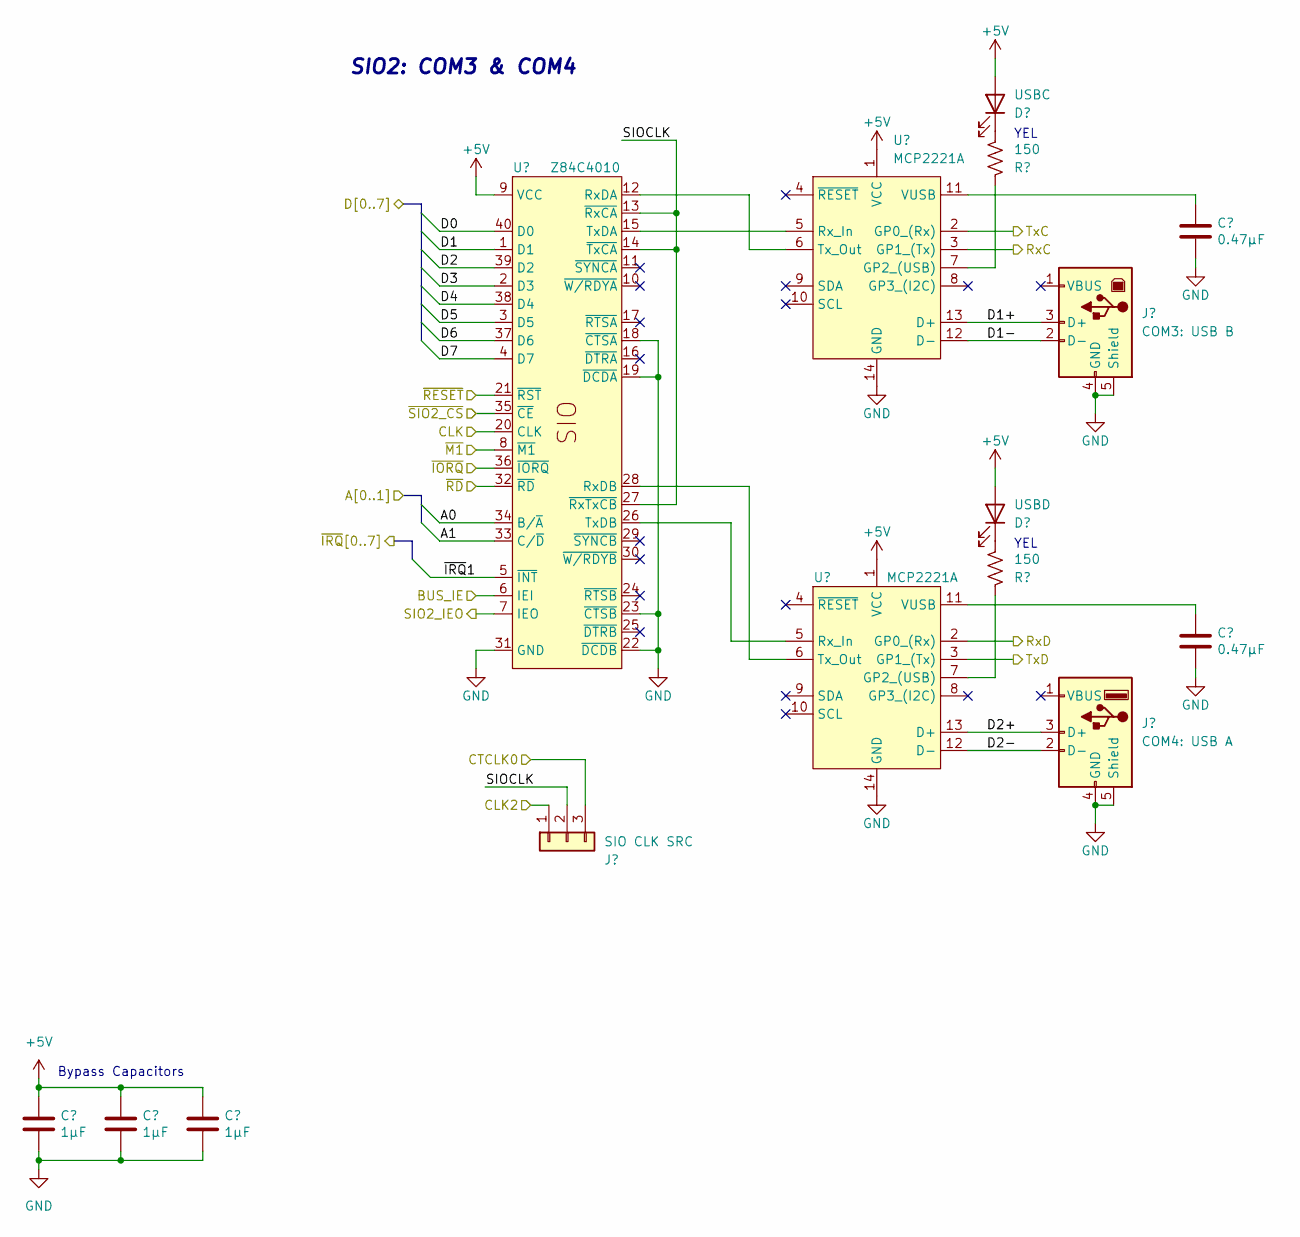
[picture p24: schematic COM3_COM4_USB.kicad_sch, COM ports 3 and 4 (TTL)]

Parts:
C18, C19, C20: 1µF; C_Disc_D3.0mm_W1.6mm_P2.50mm
C21, C22: 0.47µF; C_Disc_D3.0mm_W1.6mm_P2.50mm
D9: USBC; LED_D3.0mm_Horizontal_O1.27mm_Z2.0mm_Clear
D10: USBD; LED_D3.0mm_Horizontal_O1.27mm_Z2.0mm_Clear
J6: SIO CLK SRC; PinHeader_1x03_P2.54mm_Vertical
J7: COM3: USB B; USB_B_Lumberg_2411_02_Horizontal
J8: COM4: USB A; USB_A_Stewart_SS-52100-001_Horizontal
R3, R4: 150; R_Axial_DIN0207_L6.3mm_D2.5mm_P10.16mm_Horizontal
U9: Z84C4010; DIP-40_W15.24mm_Socket
U10, U11: MCP2221A; DIP-14_W7.62mm_Socket

Connections:
+5V: C18.1, C19.1, C20.1, D9.2 (A), D10.2 (A), U9.9 (VCC), U10.1 (VCC), U11.1 (VCC); also elsewhere on the board
/A0: U9.34 (B/~A); also elsewhere on the board
/A1: U9.33 (C/~D); also elsewhere on the board
/CLK: U9.20 (CLK); also elsewhere on the board
/CLK2: J6.1; also elsewhere on the board
/COM 3 and 4 (USB)/D1+: J7.3 (D+), U10.13 (D+)
/COM 3 and 4 (USB)/D1-: J7.2 (D-), U10.12 (D-)
/COM 3 and 4 (USB)/D2+: J8.3 (D+), U11.13 (D+)
/COM 3 and 4 (USB)/D2-: J8.2 (D-), U11.12 (D-)
/COM 3 and 4 (USB)/SIOCLK: J6.2, U9.13 (~RxCA), U9.14 (~TxCA), U9.27 (~RxTxCB)
/CTCLK0: J6.3; also elsewhere on the board
/D0: U9.40 (D0); also elsewhere on the board
/D1: U9.1 (D1); also elsewhere on the board
/D2: U9.39 (D2); also elsewhere on the board
/D3: U9.2 (D3); also elsewhere on the board
/D4: U9.38 (D4); also elsewhere on the board
/D5: U9.3 (D5); also elsewhere on the board
/D6: U9.37 (D6); also elsewhere on the board
/D7: U9.4 (D7); also elsewhere on the board
/IE: U9.6 (IEI); also elsewhere on the board
/RxC: U10.3 (GP1_(Tx)); also elsewhere on the board
/RxD: U11.2 (GP0_(Rx)); also elsewhere on the board
/SIO2_IEO: U9.7 (IEO); also elsewhere on the board
/TxC: U10.2 (GP0_(Rx)); also elsewhere on the board
/TxD: U11.3 (GP1_(Tx)); also elsewhere on the board
/~IORQ: U9.36 (~IORQ); also elsewhere on the board
/~IRQ1: U9.5 (~INT); also elsewhere on the board
/~M1: U9.8 (~M1); also elsewhere on the board
/~RD: U9.32 (~RD); also elsewhere on the board
/~RESET: U9.21 (~RST); also elsewhere on the board
/~SIO2_CS: U9.35 (~CE); also elsewhere on the board
GND: C18.2, C19.2, C20.2, C21.2, C22.2, J7.4 (GND), J7.5 (Shield), J8.4 (GND), J8.5 (Shield), U9.18 (~CTSA), U9.19 (~DCDA), U9.22 (~DCDB), U9.23 (~CTSB), U9.31 (GND), U10.14 (GND), U11.14 (GND); also elsewhere on the board
unnamed: D9.1 (K), R3.2
unnamed: D10.1 (K), R4.2
unnamed: R3.1, U10.7 (GP2_(USB))
unnamed: U9.15 (TxDA), U10.5 (Rx_In)
unnamed: U9.12 (RxDA), U10.6 (Tx_Out)
unnamed: C21.1, U10.11 (VUSB)
unnamed: R4.1, U11.7 (GP2_(USB))
unnamed: U9.26 (TxDB), U11.5 (Rx_In)
unnamed: U9.28 (RxDB), U11.6 (Tx_Out)
unnamed: C22.1, U11.11 (VUSB)

Notes on the sheet:
YEL
SIO2: COM3 & COM4
Bypass Capacitors

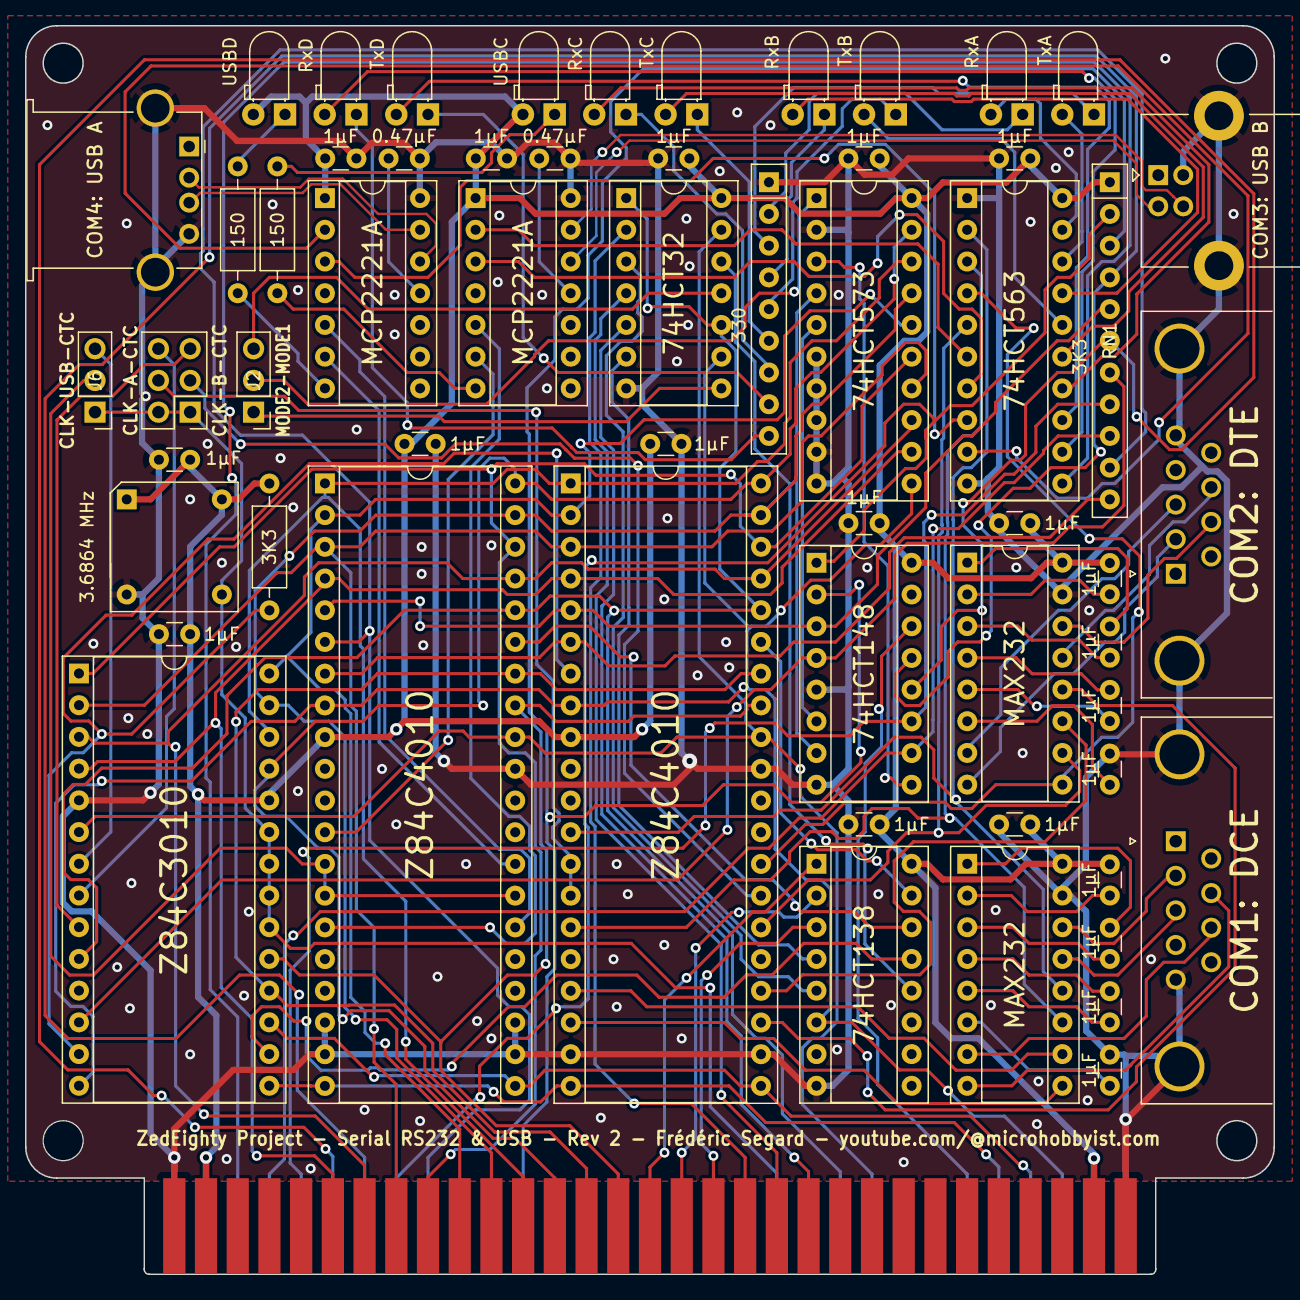
[picture p25: board 4 - Quad serial.kicad_pcb from above]

Board: 2 copper layers, 100.0 x 100.0 mm, 59 parts (0 on the bottom side), 117 nets.
