FredericSegard/Original-Z80-Homebrew/3 - CPU and memory/3 - CPU and memory.kicad_pcb

## KiCad design 3 - CPU and memory/3 - CPU and memory.kicad_pcb (2023-08-22)

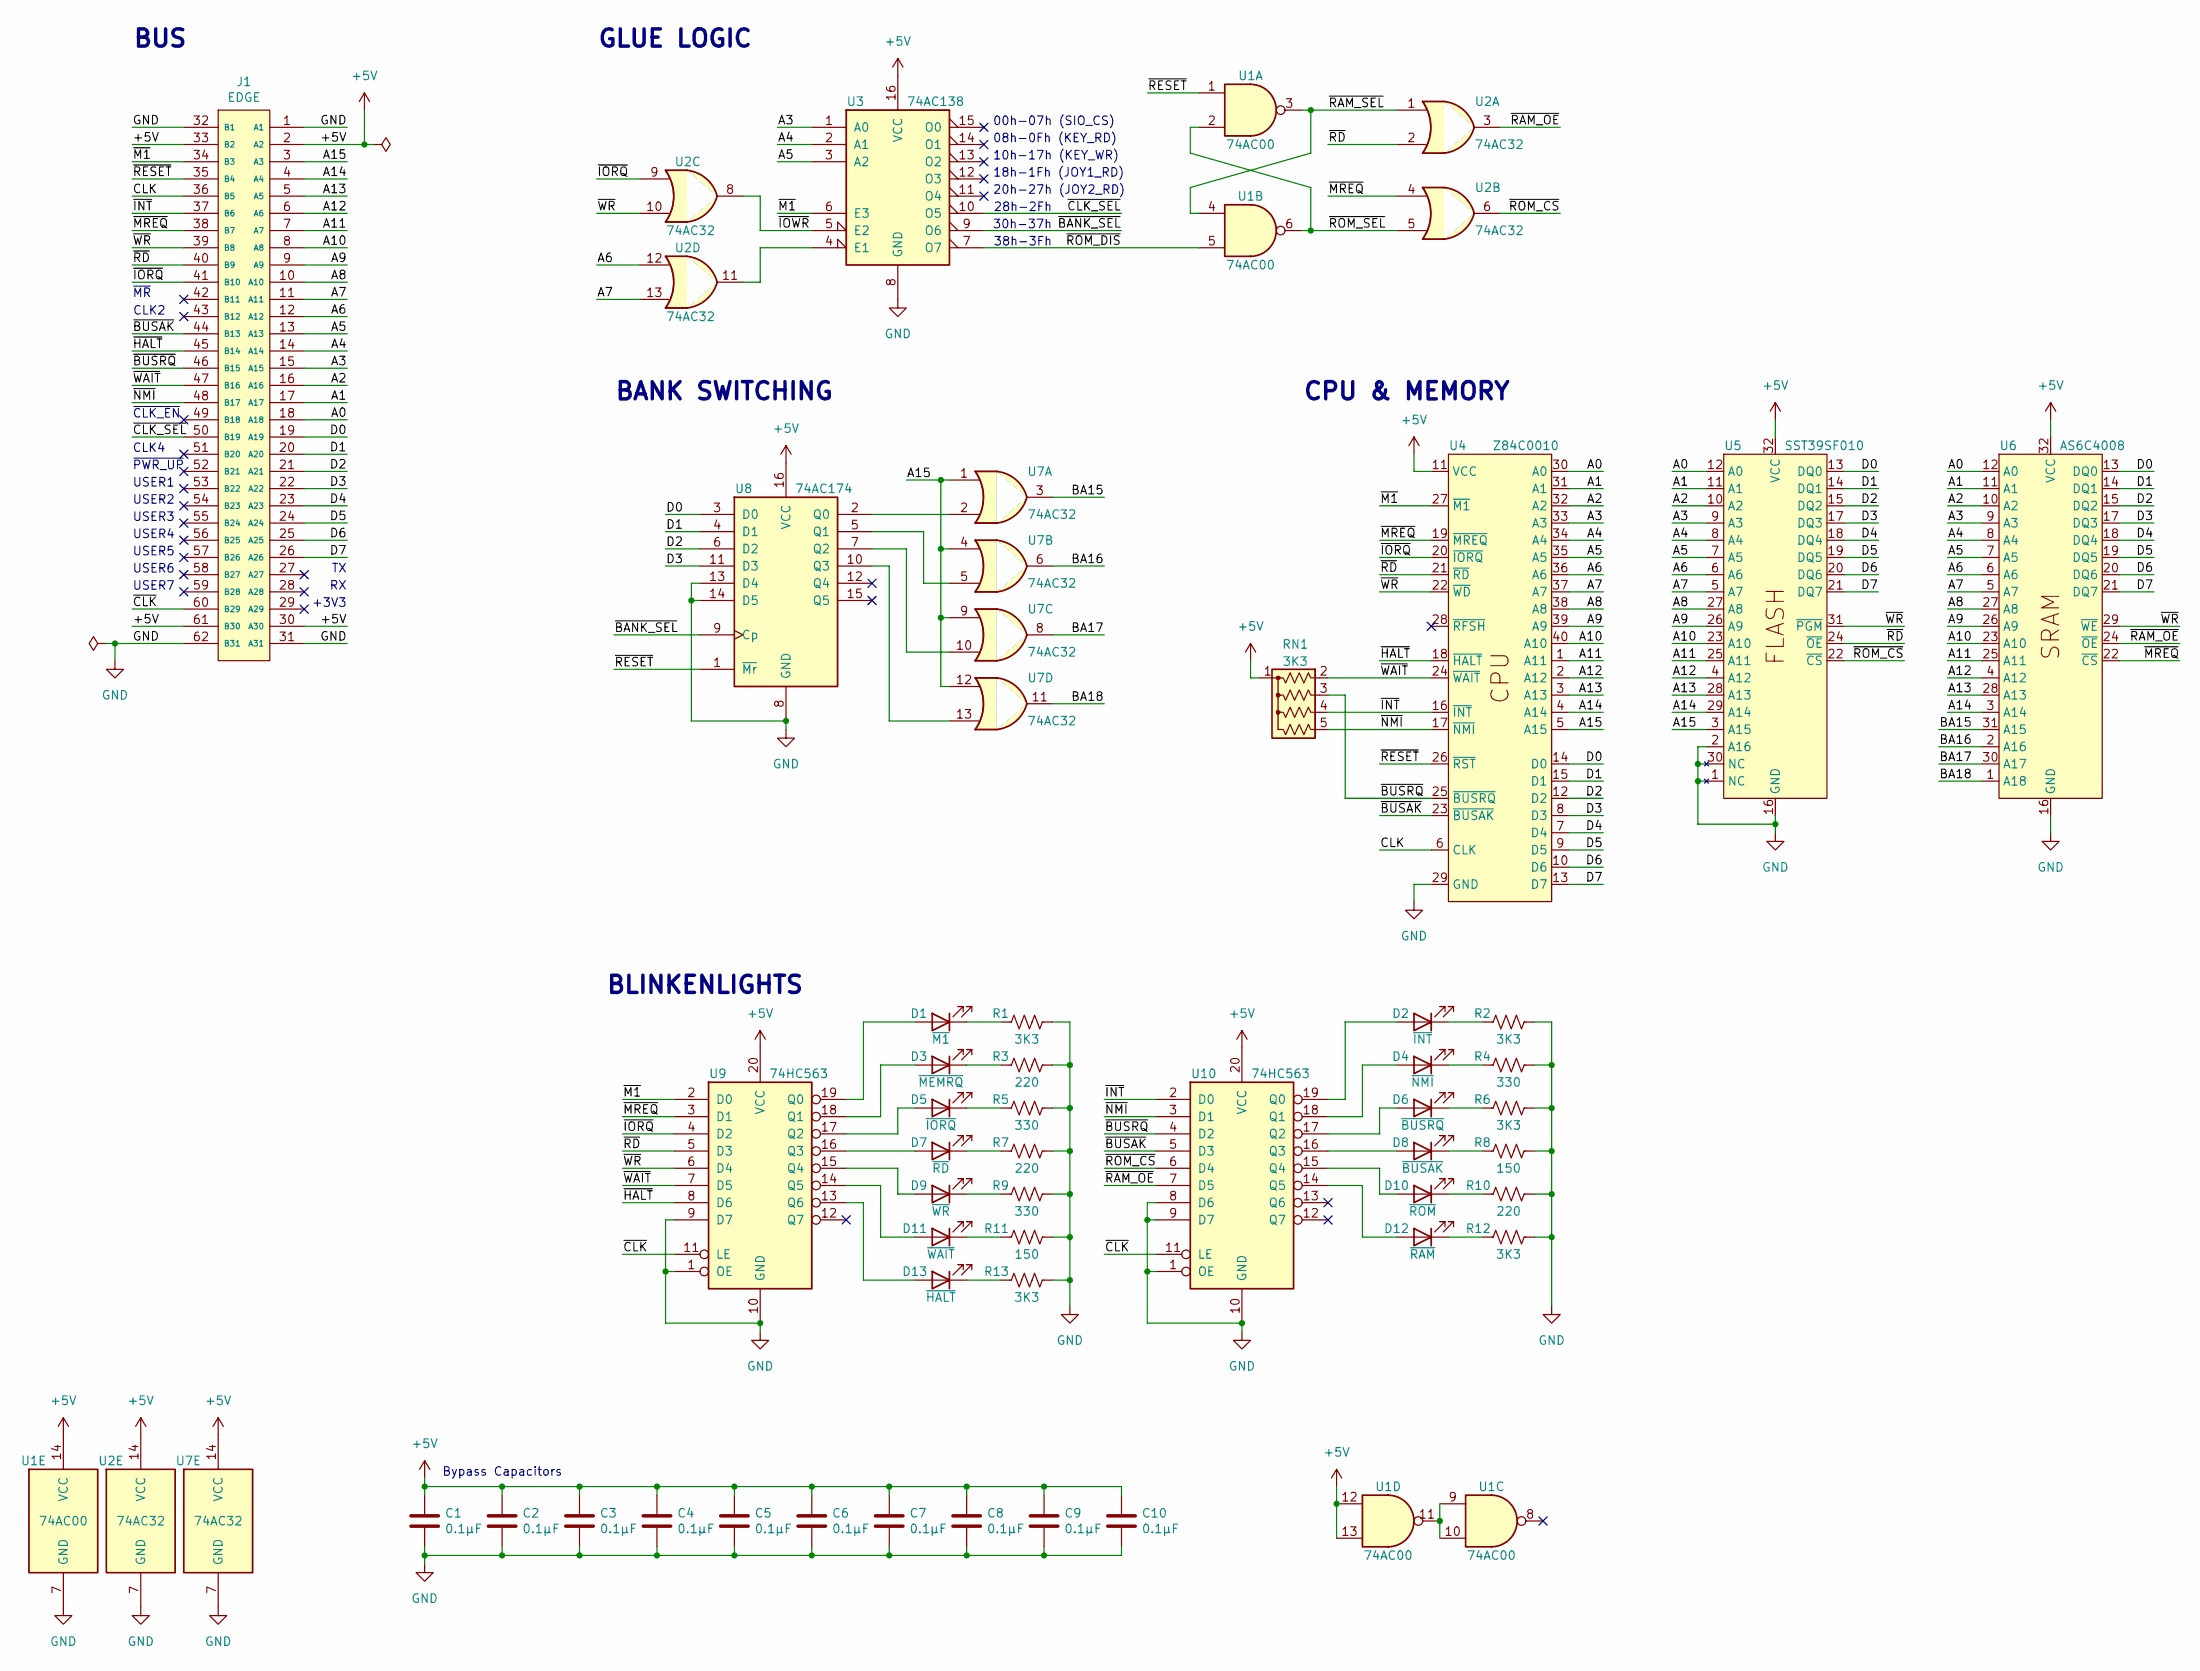
[picture p28: schematic 3 - CPU and memory.kicad_sch, CPU, 64K FLASH, 512K RAM, with blinkenlights]

Parts:
C1, C2, C3, C4, C5, C6, C7, C8, C9, C10: 0.1µF; C_Disc_D3.0mm_W1.6mm_P2.50mm
D1: ~{M1}; LED_D3.0mm_Horizontal_O1.27mm_Z2.0mm_Clear
D2: ~{INT}; LED_D3.0mm_Horizontal_O1.27mm_Z2.0mm_Clear
D3: ~{MEMRQ}; LED_D3.0mm_Horizontal_O1.27mm_Z2.0mm_Clear
D4: ~{NMI}; LED_D3.0mm_Horizontal_O1.27mm_Z2.0mm_Clear
D5: ~{IORQ}; LED_D3.0mm_Horizontal_O1.27mm_Z2.0mm_Clear
D6: ~{BUSRQ}; LED_D3.0mm_Horizontal_O1.27mm_Z2.0mm_Clear
D7: ~{RD}; LED_D3.0mm_Horizontal_O1.27mm_Z2.0mm_Clear
D8: ~{BUSAK}; LED_D3.0mm_Horizontal_O1.27mm_Z2.0mm_Clear
D9: ~{WR}; LED_D3.0mm_Horizontal_O1.27mm_Z2.0mm_Clear
D10: ~{ROM}; LED_D3.0mm_Horizontal_O1.27mm_Z2.0mm_Clear
D11: ~{WAIT}; LED_D3.0mm_Horizontal_O1.27mm_Z2.0mm_Clear
D12: ~{RAM}; LED_D3.0mm_Horizontal_O1.27mm_Z2.0mm_Clear
D13: ~{HALT}; LED_D3.0mm_Horizontal_O1.27mm_Z2.0mm_Clear
J1: EDGE; BUS_XT_Proto; Mouser Part Number 571-6-5530843-5
R1, R2, R6, R12, R13: 3K3; R_Axial_DIN0207_L6.3mm_D2.5mm_P10.16mm_Horizontal
R3, R7, R10: 220; R_Axial_DIN0207_L6.3mm_D2.5mm_P10.16mm_Horizontal
R4, R5, R9: 330; R_Axial_DIN0207_L6.3mm_D2.5mm_P10.16mm_Horizontal
R8, R11: 150; R_Axial_DIN0207_L6.3mm_D2.5mm_P10.16mm_Horizontal
RN1: 3K3; R_Array_SIP5
U1: 74AC00; DIP-14_W7.62mm_Socket
U2, U7: 74AC32; DIP-14_W7.62mm_Socket
U3: 74AC138; DIP-16_W7.62mm_Socket
U4: Z84C0010; DIP-40_W15.24mm_Socket
U5: SST39SF010; DIP-32_W15.24mm
U6: AS6C4008; DIP-32_W15.24mm
U8: 74AC174; DIP-16_W7.62mm_Socket
U9, U10: 74HC563; DIP-20_W7.62mm_Socket

Connections:
+5V: C1.1, C2.1, C3.1, C4.1, C5.1, C6.1, C7.1, C8.1, C9.1, C10.1, J1.2 (A2), J1.30 (A30), J1.33 (B2), J1.61 (B30), RN1.1 (common), U1.12, U1.13, U1.14 (VCC), U2.14 (VCC), U3.16 (VCC), U4.11 (VCC), U5.32 (VCC), U6.32 (VCC), U7.14 (VCC), U8.16 (VCC), U9.20 (VCC), U10.20 (VCC)
/A0: J1.18 (A18), U4.30 (A0), U5.12 (A0), U6.12 (A0)
/A1: J1.17 (A17), U4.31 (A1), U5.11 (A1), U6.11 (A1)
/A2: J1.16 (A16), U4.32 (A2), U5.10 (A2), U6.10 (A2)
/A3: J1.15 (A15), U3.1 (A0), U4.33 (A3), U5.9 (A3), U6.9 (A3)
/A4: J1.14 (A14), U3.2 (A1), U4.34 (A4), U5.8 (A4), U6.8 (A4)
/A5: J1.13 (A13), U3.3 (A2), U4.35 (A5), U5.7 (A5), U6.7 (A5)
/A6: J1.12 (A12), U2.12, U4.36 (A6), U5.6 (A6), U6.6 (A6)
/A7: J1.11 (A11), U2.13, U4.37 (A7), U5.5 (A7), U6.5 (A7)
/A8: J1.10 (A10), U4.38 (A8), U5.27 (A8), U6.27 (A8)
/A9: J1.9 (A9), U4.39 (A9), U5.26 (A9), U6.26 (A9)
/A10: J1.8 (A8), U4.40 (A10), U5.23 (A10), U6.23 (A10)
/A11: J1.7 (A7), U4.1 (A11), U5.25 (A11), U6.25 (A11)
/A12: J1.6 (A6), U4.2 (A12), U5.4 (A12), U6.4 (A12)
/A13: J1.5 (A5), U4.3 (A13), U5.28 (A13), U6.28 (A13)
/A14: J1.4 (A4), U4.4 (A14), U5.29 (A14), U6.3 (A14)
/A15: J1.3 (A3), U4.5 (A15), U5.3 (A15), U7.1, U7.4, U7.9, U7.12
/BA15: U6.31 (A15), U7.3
/BA16: U6.2 (A16), U7.6
/BA17: U6.30 (A17), U7.8
/BA18: U6.1 (A18), U7.11
/CLK: J1.36 (B5), U4.6 (CLK)
/D0: J1.19 (A19), U4.14 (D0), U5.13 (DQ0), U6.13 (DQ0), U8.3 (D0)
/D1: J1.20 (A20), U4.15 (D1), U5.14 (DQ1), U6.14 (DQ1), U8.4 (D1)
/D2: J1.21 (A21), U4.12 (D2), U5.15 (DQ2), U6.15 (DQ2), U8.6 (D2)
/D3: J1.22 (A22), U4.8 (D3), U5.17 (DQ3), U6.17 (DQ3), U8.11 (D3)
/D4: J1.23 (A23), U4.7 (D4), U5.18 (DQ4), U6.18 (DQ4)
/D5: J1.24 (A24), U4.9 (D5), U5.19 (DQ5), U6.19 (DQ5)
/D6: J1.25 (A25), U4.10 (D6), U5.20 (DQ6), U6.20 (DQ6)
/D7: J1.26 (A26), U4.13 (D7), U5.21 (DQ7), U6.21 (DQ7)
/~BANK_SEL: U3.9 (O6), U8.9 (Cp)
/~BUSAK: J1.44 (B13), U4.23 (~BUSAK), U10.5 (D3)
/~BUSRQ: J1.46 (B15), RN1.3 (R2), U4.25 (~BUSRQ), U10.4 (D2)
/~CLK_SEL: J1.50 (B19), U3.10 (O5)
/~CLK: J1.60 (B29), U9.11 (LE), U10.11 (LE)
/~HALT: J1.45 (B14), U4.18 (~HALT), U9.8 (D6)
/~INT: J1.37 (B6), RN1.4 (R3), U4.16 (~INT), U10.2 (D0)
/~IORQ: J1.41 (B10), U2.9, U4.20 (~IORQ), U9.4 (D2)
/~IOWR: U2.8, U3.5 (E2)
/~M1: J1.34 (B3), U3.6 (E3), U4.27 (~M1), U9.2 (D0)
/~MREQ: J1.38 (B7), U2.4, U4.19 (~MREQ), U6.22 (~CS), U9.3 (D1)
/~NMI: J1.48 (B17), RN1.5 (R4), U4.17 (~NMI), U10.3 (D1)
/~RAM_OE: U2.3, U6.24 (~OE), U10.7 (D5)
/~RAM_SEL: U1.3, U1.4, U2.1
/~RD: J1.40 (B9), U2.2, U4.21 (~RD), U5.24 (~OE), U9.5 (D3)
/~RESET: J1.35 (B4), U1.1, U4.26 (~RST), U8.1 (~Mr)
/~ROM_CS: U2.6, U5.22 (~CS), U10.6 (D4)
/~ROM_DIS: U1.5, U3.7 (O7)
/~ROM_SEL: U1.2, U1.6, U2.5
/~WAIT: J1.47 (B16), RN1.2 (R1), U4.24 (~WAIT), U9.7 (D5)
/~WR: J1.39 (B8), U2.10, U4.22 (~WD), U5.31 (~PGM), U6.29 (~WE), U9.6 (D4)
GND: C1.2, C2.2, C3.2, C4.2, C5.2, C6.2, C7.2, C8.2, C9.2, C10.2, J1.1 (A1), J1.31 (A31), J1.32 (B1), J1.62 (B31), R1.2, R2.2, R3.2, R4.2, R5.2, R6.2, R7.2, R8.2, R9.2, R10.2, R11.2, R12.2, R13.2, U1.7 (GND), U2.7 (GND), U3.8 (GND), U4.29 (GND), U5.1 (NC), U5.2 (A16), U5.16 (GND), U5.30 (NC), U6.16 (GND), U7.7 (GND), U8.8 (GND), U8.13 (D4), U8.14 (D5), U9.1 (OE), U9.9 (D7), U9.10 (GND), U10.1 (OE), U10.8 (D6), U10.9 (D7), U10.10 (GND)
unnamed: D1.2 (A), U9.19 (Q0)
unnamed: D1.1 (K), R1.1
unnamed: D2.2 (A), U10.19 (Q0)
unnamed: D2.1 (K), R2.1
unnamed: D3.2 (A), U9.18 (Q1)
unnamed: D3.1 (K), R3.1
unnamed: D4.2 (A), U10.18 (Q1)
unnamed: D4.1 (K), R4.1
unnamed: D5.2 (A), U9.17 (Q2)
unnamed: D5.1 (K), R5.1
unnamed: D6.2 (A), U10.17 (Q2)
unnamed: D6.1 (K), R6.1
unnamed: D7.2 (A), U9.16 (Q3)
unnamed: D7.1 (K), R7.1
unnamed: D8.2 (A), U10.16 (Q3)
unnamed: D8.1 (K), R8.1
unnamed: D9.2 (A), U9.15 (Q4)
unnamed: D9.1 (K), R9.1
unnamed: D10.2 (A), U10.15 (Q4)
unnamed: D10.1 (K), R10.1
unnamed: D11.2 (A), U9.14 (Q5)
unnamed: D11.1 (K), R11.1
unnamed: D12.2 (A), U10.14 (Q5)
unnamed: D12.1 (K), R12.1
unnamed: D13.2 (A), U9.13 (Q6)
unnamed: D13.1 (K), R13.1
unnamed: U1.9, U1.10, U1.11
unnamed: U2.11, U3.4 (E1)
unnamed: U7.2, U8.2 (Q0)
unnamed: U7.5, U8.5 (Q1)
unnamed: U7.10, U8.7 (Q2)
unnamed: U7.13, U8.10 (Q3)

Notes on the sheet:
08h-0Fh (KEY_RD)
~{CLK_EN}
38h-3Fh
USER1
GLUE LOGIC
00h-07h (SIO_CS)
BLINKENLIGHTS
BUS
18h-1Fh (JOY1_RD)
CPU & MEMORY
CLK2
CLK4
+3V3
USER5
USER3
USER2
30h-37h
10h-17h (KEY_WR)
USER4
20h-27h (JOY2_RD)
BANK SWITCHING
Bypass Capacitors
28h-2Fh
USER6
~{MR}
USER7
~{PWR_UP}

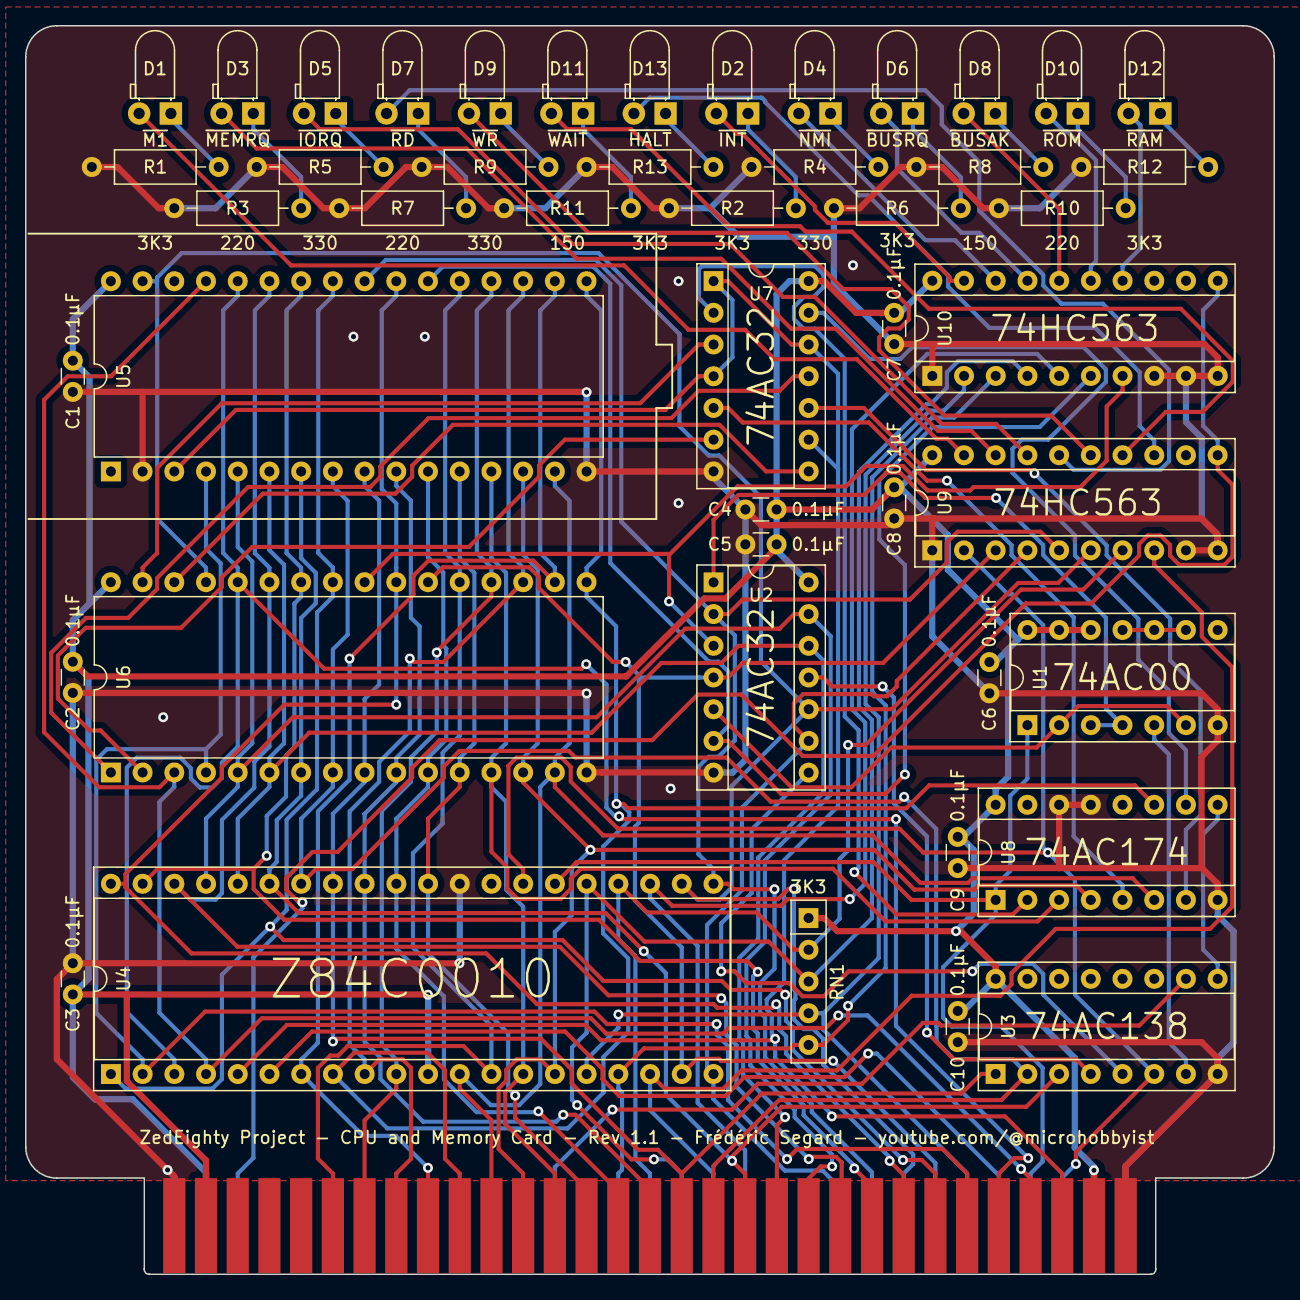
[picture p29: board 3 - CPU and memory.kicad_pcb from above]

Board: 2 copper layers, 100.0 x 100.0 mm, 48 parts (0 on the bottom side), 84 nets.
