FredericSegard/Original-Z80-Homebrew/2 - Clock/2 - Clock.kicad_pcb

## KiCad design 2 - Clock/2 - Clock.kicad_pcb (2023-08-22)

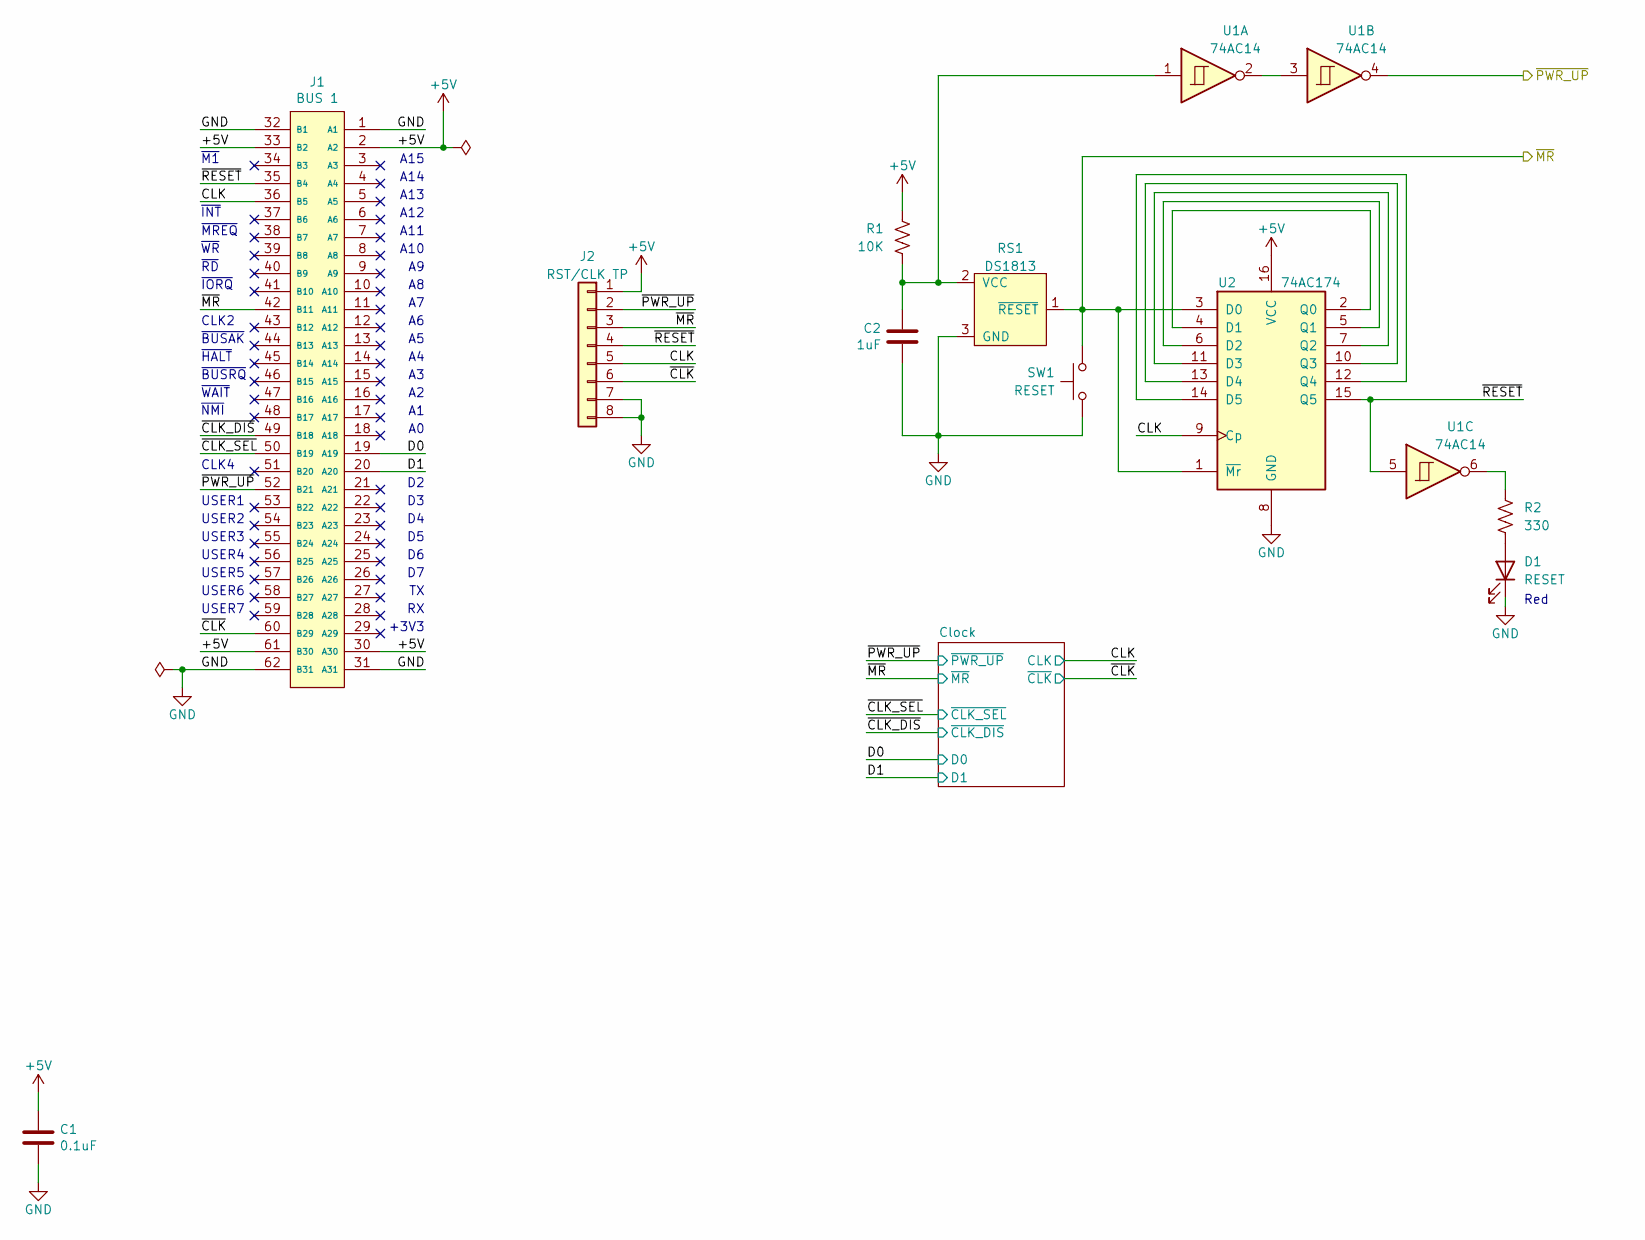
[picture p30: schematic 2 - Clock.kicad_sch, Micro Hobbyist's ZedEighty Project]

Parts:
C1: 0.1uF; C_Disc_D3.0mm_W2.0mm_P2.50mm
C2: 1uF; C_Disc_D3.0mm_W2.0mm_P2.50mm
D1: RESET; LED_D3.0mm_Horizontal_O1.27mm_Z2.0mm_Clear
J1: BUS 1; BUS_XT_Proto; Mouser Part Number 571-6-5530843-5
J2: RST/CLK TP; PinHeader_1x08_P2.54mm_Horizontal
R1: 10K; R_Axial_DIN0207_L6.3mm_D2.5mm_P10.16mm_Horizontal
R2: 330; R_Axial_DIN0207_L6.3mm_D2.5mm_P10.16mm_Horizontal
RS1: DS1813; TO-92L_Inline_Wide
SW1: RESET; SW_Tactile_SPST_Angled_PTS645Vx58-2LFS
U1: 74AC14; DIP-14_W7.62mm_Socket
U2: 74AC174; DIP-16_W7.62mm_Socket

Connections:
+5V: C1.1, J1.2 (A2), J1.30 (A30), J1.33 (B2), J1.61 (B30), J2.1, R1.2, U2.16 (VCC); also elsewhere on the board
/CLK: J1.36 (B5), J2.5, U2.9 (Cp); also elsewhere on the board
/D0: J1.19 (A19); also elsewhere on the board
/D1: J1.20 (A20); also elsewhere on the board
/~CLK_DIS: J1.49 (B18); also elsewhere on the board
/~CLK_SEL: J1.50 (B19); also elsewhere on the board
/~CLK: J1.60 (B29), J2.6; also elsewhere on the board
/~MR: J1.42 (B11), J2.3, RS1.1 (~RESET), SW1.1, U2.1 (~Mr), U2.3 (D0); also elsewhere on the board
/~PWR_UP: J1.52 (B21), J2.2, U1.4; also elsewhere on the board
/~RESET: J1.35 (B4), J2.4, U1.5, U2.15 (Q5)
GND: C1.2, C2.2, D1.1 (K), J1.1 (A1), J1.31 (A31), J1.32 (B1), J1.62 (B31), J2.7, J2.8, RS1.3 (GND), SW1.2, U2.8 (GND); also elsewhere on the board
unnamed: D1.2 (A), R2.2
unnamed: R2.1, U1.6
unnamed: C2.1, R1.1, RS1.2 (VCC), U1.1
unnamed: U1.2, U1.3
unnamed: U2.2 (Q0), U2.4 (D1)
unnamed: U2.5 (Q1), U2.6 (D2)
unnamed: U2.7 (Q2), U2.11 (D3)
unnamed: U2.10 (Q3), U2.13 (D4)
unnamed: U2.12 (Q4), U2.14 (D5)

Notes on the sheet:
A13
+3V3
USER6
~{NMI}
Red
~{RD}
A10
A11
USER2
USER5
A14
~{BUSRQ}
A15
~{IORQ}
USER3
CLK4
USER4
~{WR}
~{INT}
~{BUSAK}
CLK2
~{HALT}
USER7
~{MREQ}
~{WAIT}
USER1
A12
~{M1}
