FredericSegard/Original-Z80-Homebrew/2 - Clock/2 - Clock.kicad_pcb

## KiCad design 2 - Clock/2 - Clock.kicad_pcb (continued)

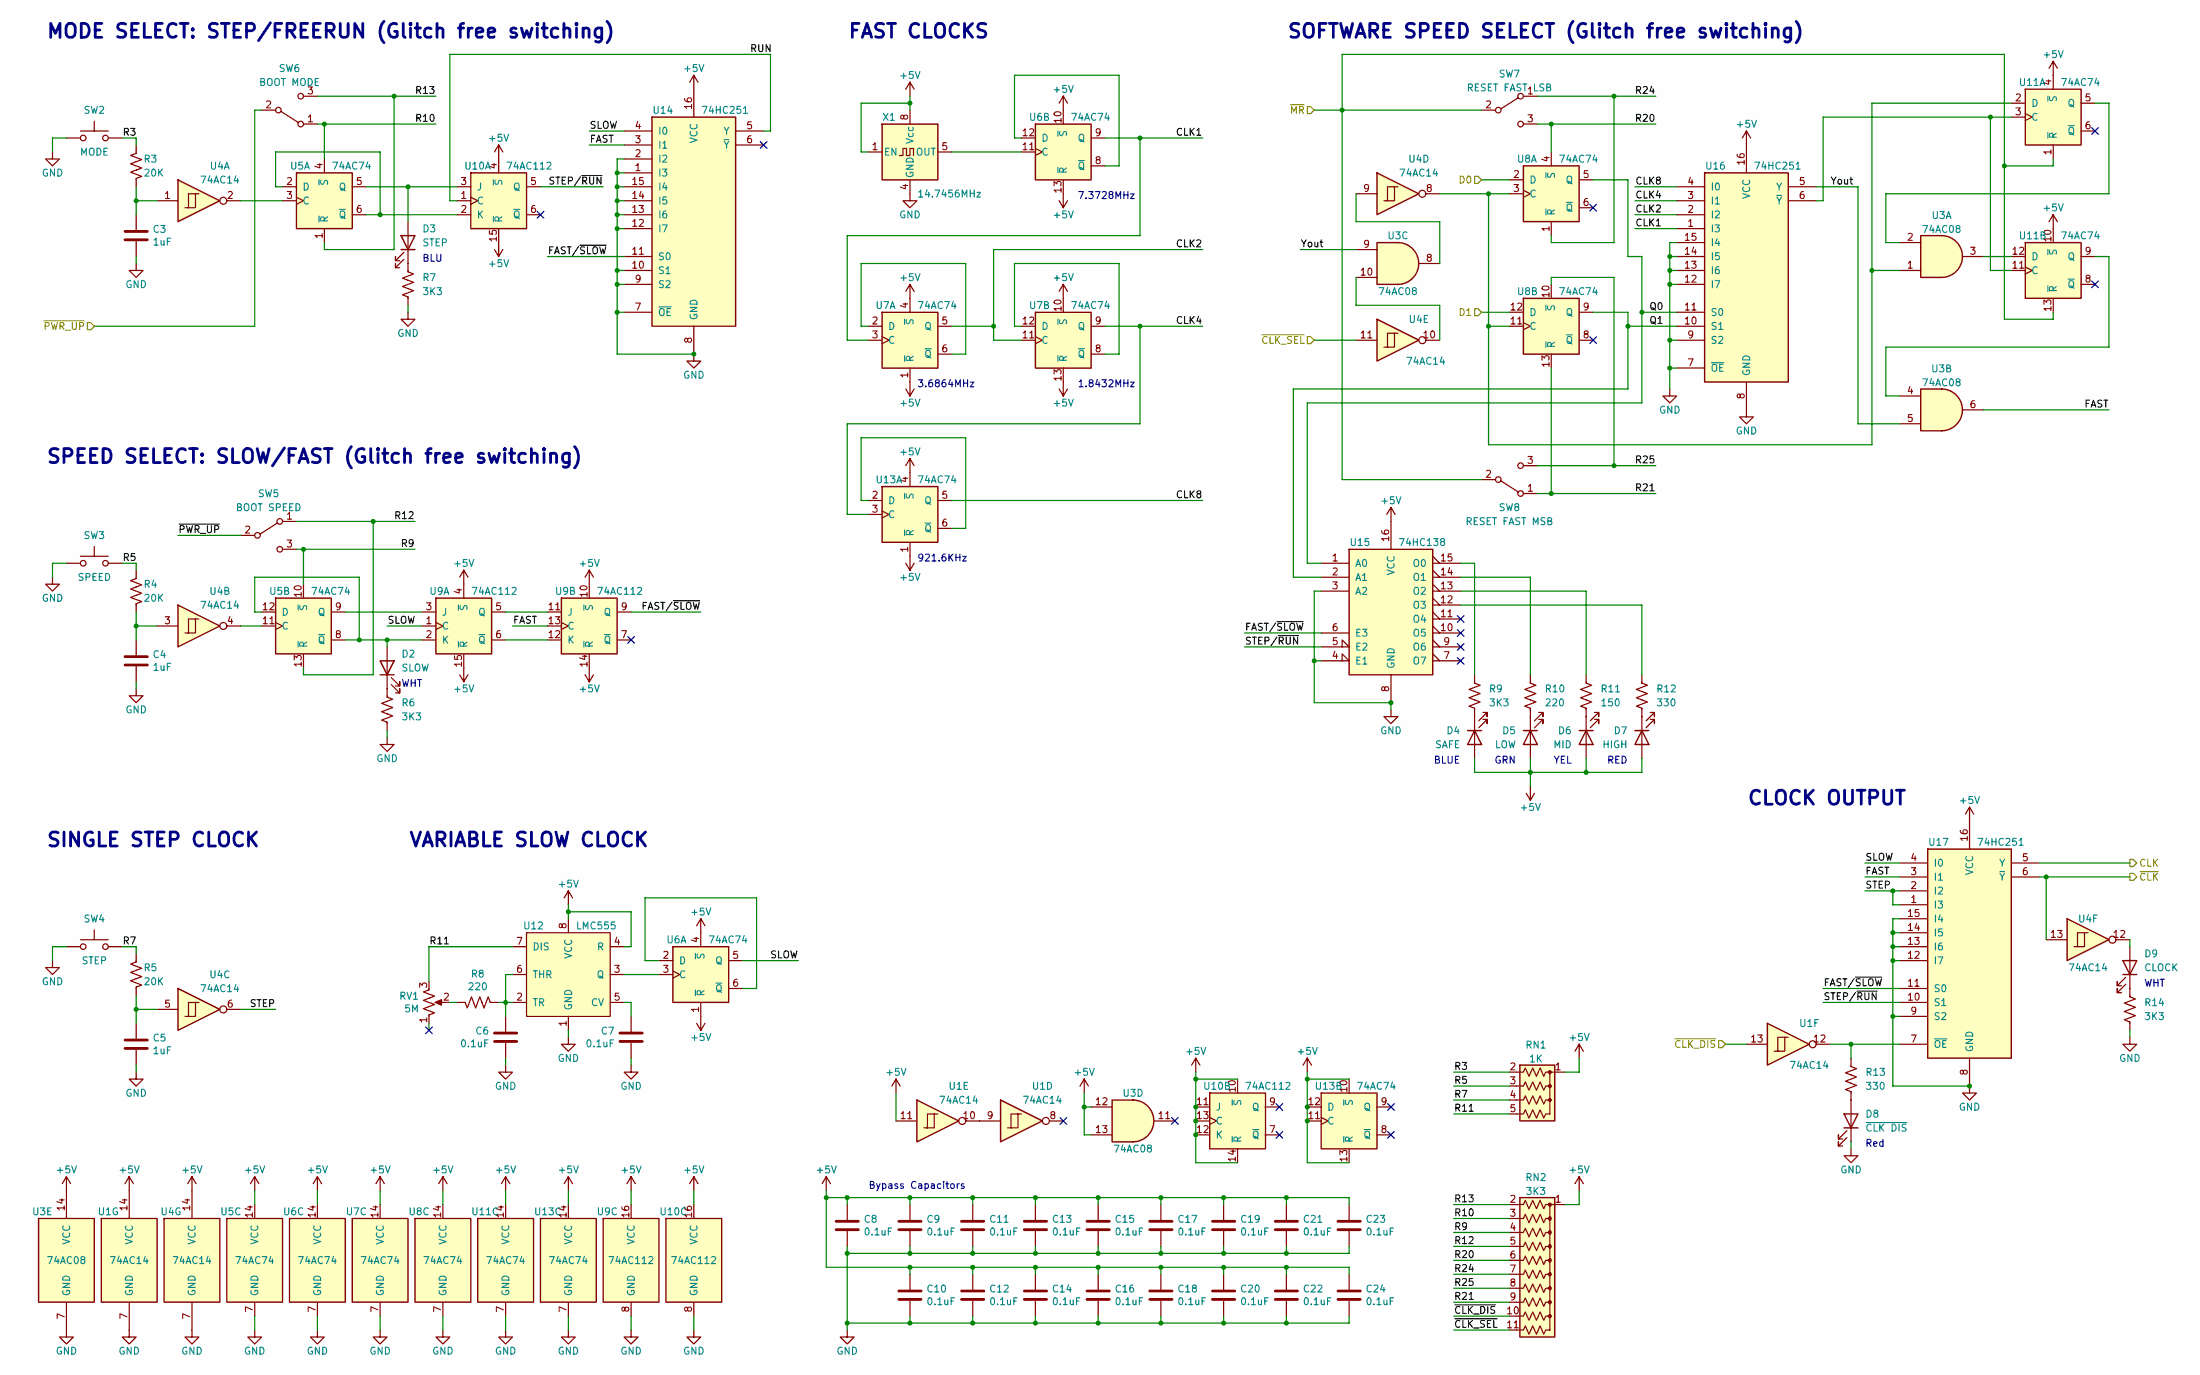
[picture p31: schematic Clock.kicad_sch, Manual and software selectable clock]

Parts:
C3, C4, C5: 1uF; C_Disc_D3.0mm_W1.6mm_P2.50mm
C6, C7, C8, C9, C10, C11, C12, C13, C14, C15, C16, C17, C18, C19, C20, C21, C22, C23, C24: 0.1uF; C_Disc_D3.0mm_W1.6mm_P2.50mm
D2: SLOW; LED_D3.0mm_Horizontal_O1.27mm_Z2.0mm_Clear
D3: STEP; LED_D3.0mm_Horizontal_O1.27mm_Z2.0mm_Clear
D4: SAFE; LED_D3.0mm_Horizontal_O1.27mm_Z2.0mm_Clear
D5: LOW; LED_D3.0mm_Horizontal_O1.27mm_Z2.0mm_Clear
D6: MID; LED_D3.0mm_Horizontal_O1.27mm_Z2.0mm_Clear
D7: HIGH; LED_D3.0mm_Horizontal_O1.27mm_Z2.0mm_Clear
D8: ~{CLK DIS}; LED_D3.0mm_Horizontal_O1.27mm_Z2.0mm_Clear
D9: CLOCK; LED_D3.0mm_Horizontal_O1.27mm_Z2.0mm_Clear
R3, R4, R5: 20K; R_Axial_DIN0207_L6.3mm_D2.5mm_P10.16mm_Horizontal
R6, R7, R9, R14: 3K3; R_Axial_DIN0207_L6.3mm_D2.5mm_P10.16mm_Horizontal
R8, R10: 220; R_Axial_DIN0207_L6.3mm_D2.5mm_P10.16mm_Horizontal
R11: 150; R_Axial_DIN0207_L6.3mm_D2.5mm_P10.16mm_Horizontal
R12, R13: 330; R_Axial_DIN0207_L6.3mm_D2.5mm_P10.16mm_Horizontal
RN1: 1K; R_Array_SIP5
RN2: 3K3; R_Array_SIP11
RV1: 5M; Potentiometer_Bourns_3296Z_Horizontal
SW2: MODE; SW_Tactile_SPST_Angled_PTS645Vx58-2LFS
SW3: SPEED; SW_Tactile_SPST_Angled_PTS645Vx58-2LFS
SW4: STEP; SW_Tactile_SPST_Angled_PTS645Vx58-2LFS
SW5: BOOT SPEED; Microswitch_4.7mm_spacing
SW6: BOOT MODE; Microswitch_4.7mm_spacing
SW7: RESET FAST LSB; Microswitch_4.7mm_spacing
SW8: RESET FAST MSB; Microswitch_4.7mm_spacing
U1, U4: 74AC14; DIP-14_W7.62mm_Socket
U3: 74AC08; DIP-14_W7.62mm_Socket
U5, U6, U7, U8, U11, U13: 74AC74; DIP-14_W7.62mm_Socket
U9, U10: 74AC112; DIP-16_W7.62mm_Socket
U12: LMC555; DIP-8_W7.62mm_Socket
U14, U16, U17: 74HC251; DIP-16_W7.62mm_Socket
U15: 74HC138; DIP-16_W7.62mm_Socket
X1: 14.7456MHz; DIP-8-4_W7.62mm_Oscillator_Socket

Connections:
+5V: C8.1, C9.1, C10.1, C11.1, C12.1, C13.1, C14.1, C15.1, C16.1, C17.1, C18.1, C19.1, C20.1, C21.1, C22.1, C23.1, C24.1, D4.2 (A), D5.2 (A), D6.2 (A), D7.2 (A), RN1.1 (common), RN2.1 (common), U1.11, U1.14 (VCC), U3.12, U3.13, U3.14 (VCC), U4.14 (VCC), U5.14 (VCC), U6.1 (~R), U6.4 (~S), U6.10 (~S), U6.13 (~R), U6.14 (VCC), U7.1 (~R), U7.4 (~S), U7.10 (~S), U7.13 (~R), U7.14 (VCC), U8.14 (VCC), U9.4 (~S), U9.10 (~S), U9.14 (~R), U9.15 (~R), U9.16 (VCC), U10.4 (~S), U10.10 (~S), U10.11 (J), U10.12 (K), U10.13 (C), U10.14 (~R), U10.15 (~R), U10.16 (VCC), U11.4 (~S), U11.10 (~S), U11.14 (VCC), U12.4 (R), U12.8 (VCC), U13.1 (~R), U13.4 (~S), U13.10 (~S), U13.11 (C), U13.12 (D), U13.13 (~R), U13.14 (VCC), U14.16 (VCC), U15.16 (VCC), U16.16 (VCC), U17.16 (VCC), X1.1 (EN), X1.8 (Vcc); also elsewhere on the board
/CLK: U17.5 (Y); also elsewhere on the board
/Clock/CLK1: U6.9 (Q), U7.3 (C), U16.1 (I3)
/Clock/CLK2: U7.5 (Q), U7.11 (C), U16.2 (I2)
/Clock/CLK4: U7.9 (Q), U13.3 (C), U16.3 (I1)
/Clock/CLK8: U13.5 (Q), U16.4 (I0)
/Clock/FAST: U3.6, U9.13 (C), U14.3 (I1), U17.3 (I1)
/Clock/FAST/~SLOW: U9.9 (Q), U14.11 (S0), U15.6 (E3), U17.11 (S0)
/Clock/Q0: U8.5 (Q), U15.1 (A0), U16.11 (S0)
/Clock/Q1: U8.9 (Q), U15.2 (A1), U16.10 (S1)
/Clock/R3: R3.2, RN1.2 (R1), SW2.1
/Clock/R5: R4.2, RN1.3 (R2), SW3.1
/Clock/R7: R5.2, RN1.4 (R3), SW4.1
/Clock/R9: RN2.4 (R3), SW5.3 (C), U5.10 (~S)
/Clock/R10: RN2.3 (R2), SW6.1 (A), U5.4 (~S)
/Clock/R11: RN1.5 (R4), RV1.3, U12.7 (DIS)
/Clock/R12: RN2.5 (R4), SW5.1 (A), U5.13 (~R)
/Clock/R13: RN2.2 (R1), SW6.3 (C), U5.1 (~R)
/Clock/R20: RN2.6 (R5), SW7.3 (C), U8.4 (~S)
/Clock/R21: RN2.9 (R8), SW8.1 (A), U8.13 (~R)
/Clock/R24: RN2.7 (R6), SW7.1 (A), U8.1 (~R)
/Clock/R25: RN2.8 (R7), SW8.3 (C), U8.10 (~S)
/Clock/RUN: U10.1 (C), U14.5 (Y)
/Clock/SLOW: U6.5 (Q), U9.1 (C), U14.4 (I0), U17.4 (I0)
/Clock/STEP: U4.6, U17.1 (I3), U17.2 (I2)
/Clock/STEP/~RUN: U10.5 (Q), U15.5 (E2), U17.10 (S1)
/Clock/Yout: U3.5, U3.9, U16.5 (Y)
/D0: U8.2 (D); also elsewhere on the board
/D1: U8.12 (D); also elsewhere on the board
/~CLK_DIS: RN2.10 (R9), U1.13; also elsewhere on the board
/~CLK_SEL: RN2.11 (R10), U4.11; also elsewhere on the board
/~CLK: U4.13, U17.6 (~Y); also elsewhere on the board
/~MR: SW7.2 (B), SW8.2 (B), U11.1 (~R), U11.13 (~R); also elsewhere on the board
/~PWR_UP: SW5.2 (B), SW6.2 (B); also elsewhere on the board
GND: C3.2, C4.2, C5.2, C6.2, C7.2, C8.2, C9.2, C10.2, C11.2, C12.2, C13.2, C14.2, C15.2, C16.2, C17.2, C18.2, C19.2, C20.2, C21.2, C22.2, C23.2, C24.2, D8.1 (K), R6.2, R7.2, R14.2, SW2.2, SW3.2, SW4.2, U1.7 (GND), U3.7 (GND), U4.7 (GND), U5.7 (GND), U6.7 (GND), U7.7 (GND), U8.7 (GND), U9.8 (GND), U10.8 (GND), U11.7 (GND), U12.1 (GND), U13.7 (GND), U14.1 (I3), U14.2 (I2), U14.7 (~OE), U14.8 (GND), U14.9 (S2), U14.10 (S1), U14.12 (I7), U14.13 (I6), U14.14 (I5), U14.15 (I4), U15.3 (A2), U15.4 (E1), U15.8 (GND), U16.7 (~OE), U16.8 (GND), U16.9 (S2), U16.12 (I7), U16.13 (I6), U16.14 (I5), U16.15 (I4), U17.8 (GND), U17.9 (S2), U17.12 (I7), U17.13 (I6), U17.14 (I5), U17.15 (I4), X1.4 (GND); also elsewhere on the board
unnamed: C3.1, R3.1, U4.1
unnamed: C4.1, R4.1, U4.3
unnamed: C5.1, R5.1, U4.5
unnamed: D2.2 (A), U5.8 (~Q), U5.12 (D), U9.2 (K)
unnamed: D2.1 (K), R6.1
unnamed: D3.2 (A), U5.5 (Q), U10.3 (J)
unnamed: D3.1 (K), R7.1
unnamed: D4.1 (K), R9.2
unnamed: D5.1 (K), R10.2
unnamed: D6.1 (K), R11.2
unnamed: D7.1 (K), R12.2
unnamed: D8.2 (A), R13.2
unnamed: D9.2 (A), U4.12
unnamed: D9.1 (K), R14.1
unnamed: R8.1, RV1.2
unnamed: U1.9, U1.10
unnamed: U3.8, U4.9
unnamed: U3.10, U4.10
unnamed: U4.2, U5.3 (C)
unnamed: U4.4, U5.11 (C)
unnamed: U5.9 (Q), U9.3 (J)
unnamed: U6.2 (D), U6.6 (~Q)
unnamed: U6.11 (C), X1.5 (OUT)
unnamed: U6.8 (~Q), U6.12 (D)
unnamed: U7.2 (D), U7.6 (~Q)
unnamed: U7.8 (~Q), U7.12 (D)
unnamed: U9.5 (Q), U9.11 (J)
unnamed: U9.6 (~Q), U9.12 (K)
unnamed: U5.2 (D), U5.6 (~Q), U10.2 (K)
unnamed: U11.3 (C), U11.11 (C), U16.6 (~Y)
unnamed: U3.1, U4.8, U8.3 (C), U8.11 (C), U11.2 (D)
unnamed: U3.2, U11.5 (Q)
unnamed: U3.3, U11.12 (D)
unnamed: U3.4, U11.9 (Q)
unnamed: C7.1, U12.5 (CV)
unnamed: U6.3 (C), U12.3 (Q)
unnamed: C6.1, R8.2, U12.2 (TR), U12.6 (THR)
unnamed: U13.2 (D), U13.6 (~Q)
unnamed: R9.1, U15.15 (O0)
unnamed: R10.1, U15.14 (O1)
unnamed: R11.1, U15.13 (O2)
unnamed: R12.1, U15.12 (O3)
unnamed: R13.1, U1.12, U17.7 (~OE)

Notes on the sheet:
3.6864MHz
VARIABLE SLOW CLOCK
SPEED SELECT: SLOW/FAST (Glitch free switching)
Bypass Capacitors
MODE SELECT: STEP/FREERUN (Glitch free switching)
RED
FAST CLOCKS
SOFTWARE SPEED SELECT (Glitch free switching)
CLOCK OUTPUT
921.6KHz
GRN
WHT
1.8432MHz
BLU
Red
7.3728MHz
YEL
BLUE
SINGLE STEP CLOCK

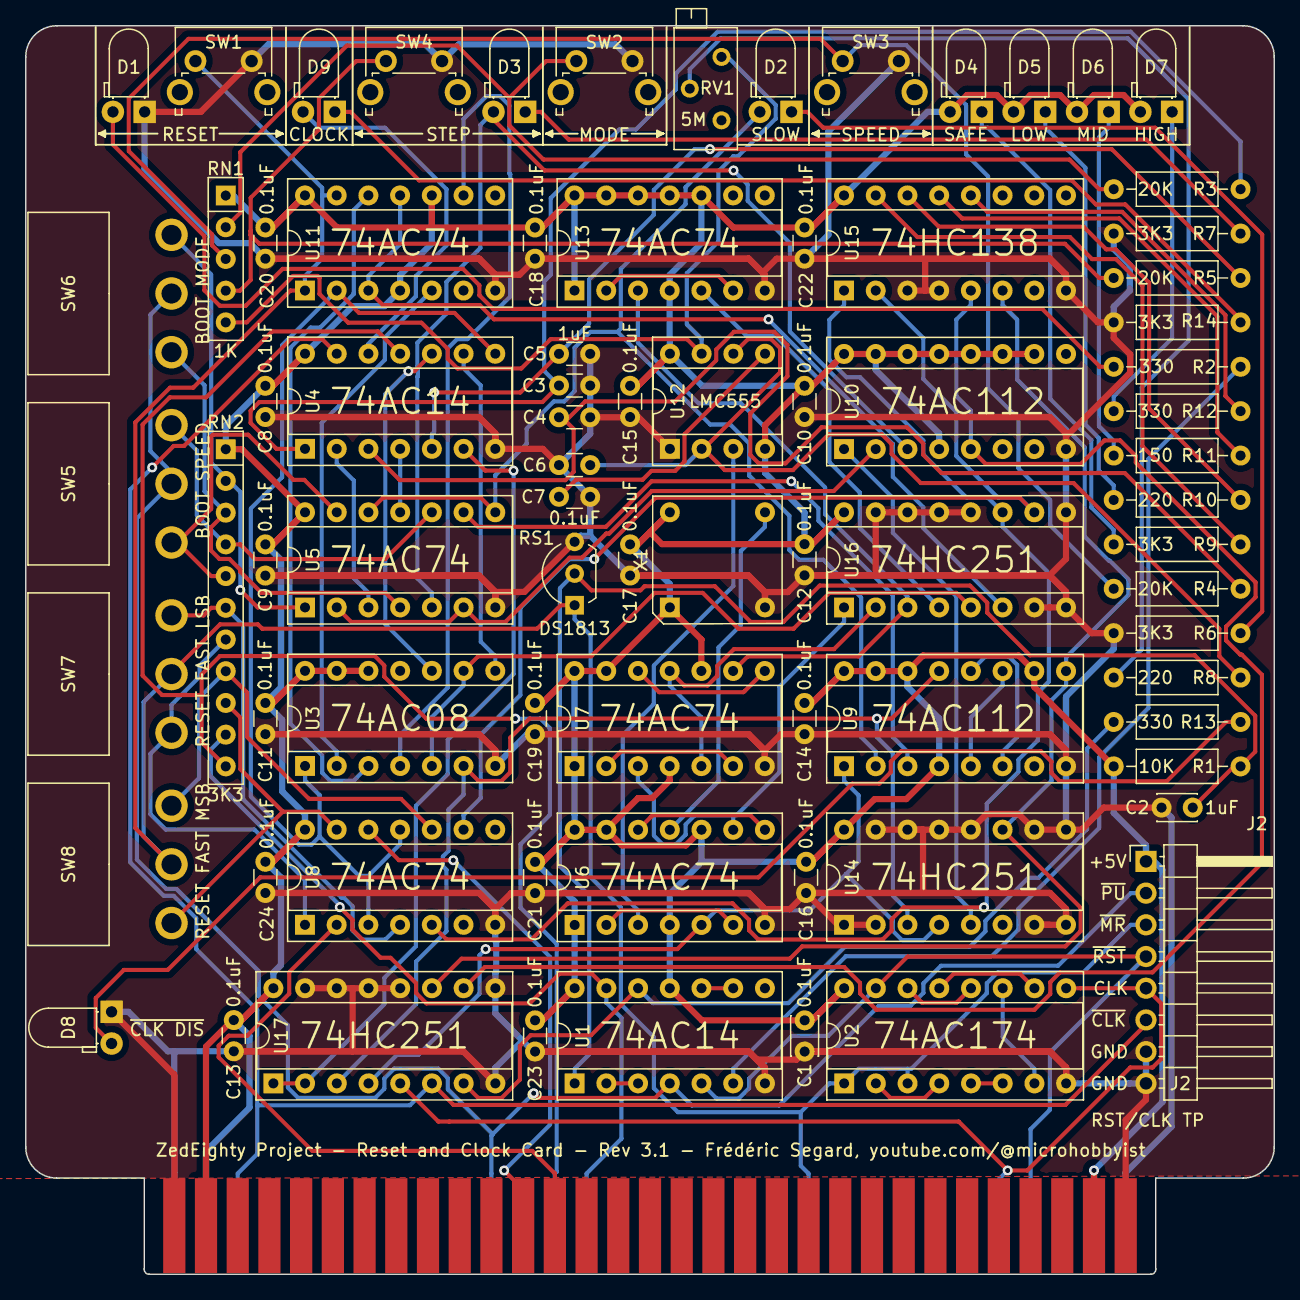
[picture p32: board 2 - Clock.kicad_pcb from above]

Board: 2 copper layers, 100.0 x 100.0 mm, 79 parts (0 on the bottom side), 88 nets.
