FredericSegard/Original-Z80-Homebrew/(commit log)

2023-08-22 Converted files from version 6 to 7 of KiCad
    [1 - Backplkane-B_Cu.gbl, 1 - Backplkane-B_Mask.gbs, 1 - Backplkane-B_Paste.gbp, 1 - Backplkane-B_Silkscreen.gbo, 1 - Backplkane-Edge_Cuts.gm1, 1 - Backplkane-F_Cu.gtl, 1 - Backplkane-F_Mask.gts, 1 - Backplkane-F_Paste.gtp]
2023-08-22 Clock card updated
    [2 - Clock-B_Cu.gbl, 2 - Clock-B_Mask.gbs, 2 - Clock-B_Paste.gbp, 2 - Clock-B_Silkscreen.gbo, 2 - Clock-Edge_Cuts.gm1, 2 - Clock-F_Cu.gtl, 2 - Clock-F_Mask.gts, 2 - Clock-F_Paste.gtp]
2023-08-22 Imported CPU card without converting Kicad 6 to 7 problems
    [3 - CPU and memory.dsn, 3 - CPU and memory.kicad_pcb, 3 - CPU and memory.kicad_sch]
2023-08-22 Update 3 - CPU and memory.kicad_prl
2023-08-22 Finished cleaning up the project
    [3 - CPU and memory.kicad_pcb, 3 - CPU and memory.kicad_sch]
2023-08-22 Added gerbers
    [3 - CPU and memory-B_Cu.gbl, 3 - CPU and memory-B_Mask.gbs, 3 - CPU and memory-B_Paste.gbp, 3 - CPU and memory-B_Silkscreen.gbo, 3 - CPU and memory-Edge_Cuts.gm1, 3 - CPU and memory-F_Cu.gtl, 3 - CPU and memory-F_Mask.gts, 3 - CPU and memory-F_Paste.gtp]
2023-08-24 Added serial card, still needs work
    [1 - Backplkane.kicad_pcb, 1 - Backplkane.kicad_sch, 2 - Clock.kicad_sch, 3 - CPU and memory.kicad_sch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]
2023-08-25 In the process of routing the board
    [3 - Quad Serial card v3.dsn, 4 - Quad serial - Copy.kicad_pcb, 4 - Quad serial.kicad_pcb, 4 - Quad serial.kicad_sch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]
2023-08-26 Made a mess of things a bit.
    Software clock is non-functional. Worked on the breadboard, but makes the CPU board crash when writing to the IO port to select clock speed.
    [3 - CPU and memory.kicad_sch, 4 - Quad serial - Copy.kicad_pcb, 4 - Quad serial.kicad_pcb, COM3_COM4_USB.kicad_sch]
2023-09-11 Rerouted some traces and readied the the gerber to send out to manufacturing
    [4 - Quad serial-B_Cu.gbl, 4 - Quad serial-B_Mask.gbs, 4 - Quad serial-B_Paste.gbp, 4 - Quad serial-B_Silkscreen.gbo, 4 - Quad serial-Edge_Cuts.gm1, 4 - Quad serial-F_Cu.gtl, 4 - Quad serial-F_Mask.gts, 4 - Quad serial-F_Paste.gtp]
2023-12-28 Misc changes
    [Clock.kicad_sch]
